guusleenders/Multi-RAT-for-IoT--The-Potential-in-Combining-LoRaWAN-and-NB-IoT/Experiments/LoRaWAN/lora-latency.tex

% This file was created by tikzplotlib v0.9.1.
\begin{tikzpicture}

\begin{axis}
[
axis line style={black},
axis lines* = {left},
legend cell align={left},
legend style={fill opacity=1, draw=none, text opacity=1},
legend style={nodes={scale=0.7, transform shape}, at={(0.03,0.8)},anchor=west},
tick align=outside,
tick pos=left,
width = \linewidth,
height = 0.7\linewidth,
x grid style={white!69.01960784313725!black},
grid,
grid style={help lines,color=gray!50, dashed},
xlabel={data block\_size},
xmajorgrids,
xmin=-71.20000, xmax=1671.20000,
xtick style={color=black},
xlabel={Data Block Size [\si{\byte}]},
ylabel={Latency (\si{\hour})},
ymajorgrids,
ymin=-0.26150, ymax=24.49369,
ytick style={color=black},
label style={font=\footnotesize},
tick label style={font=\footnotesize},
minor tick num=1,
yminorgrids,
ymajorgrids,
xminorgrids,
y filter/.code={\pgfmathparse{#1*3.1}\pgfmathresult}
]
\addplot [thick, colorSF7]
table {%
% 8.00000 0.00010
% 16.00000 0.00016
% 24.00000 0.00020
% 32.00000 0.00024
% 40.00000 0.00028
% 48.00000 0.00034
% 56.00000 0.00038
% 64.00000 0.00042
% 72.00000 0.00047
% 80.00000 0.00051
% 88.00000 0.00055
% 96.00000 0.00059
% 104.00000 0.00065
% 112.00000 0.00069
% 120.00000 0.00073
% 128.00000 0.00079
% 136.00000 0.00083
% 144.00000 0.00086
% 152.00000 0.00090
% 160.00000 0.00096
% 168.00000 0.00100
% 176.00000 0.00104
% 184.00000 0.00110
% 192.00000 0.00114
% 200.00000 0.00118
% 208.00000 0.00122
% 216.00000 0.00128
% 224.00000 0.00131
% 232.00000 0.00144
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
% 232.00000 0.10068
% 240.00000 0.12773
% 248.00000 0.13398
% 256.00000 0.13961
% 264.00000 0.14336
% 272.00000 0.14961
% 280.00000 0.15274
% 288.00000 0.15899
% 296.00000 0.19667
% 304.00000 0.20042
% 312.00000 0.20793
% 320.00000 0.21168
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
};
\addlegendentry{SF12}
\end{axis}

\end{tikzpicture}
