guusleenders/Multi-RAT-for-IoT--The-Potential-in-Combining-LoRaWAN-and-NB-IoT/Experiments/LoRaWAN/lora_energy_per_payload_byte.tex

% This file was created by tikzplotlib v0.9.1.
\begin{tikzpicture}

\begin{axis}[
axis line style={black},
axis lines* = {left},
legend cell align={left},
legend style={ at={(0.5,-0.3)},anchor=north, fill opacity=0.8, draw opacity=1, text opacity=1, draw=white!80.00000!black, /tikz/column 2/.style={column sep=5pt}, /tikz/column 3/.style={column sep=5pt},/tikz/column 4/.style={column sep=5pt}},
legend style={nodes={scale=0.7, transform shape}},
legend columns=4, 
tick align=outside,
tick pos=left,
width = \linewidth,
height=0.6\linewidth,
x grid style={white!69.01960784313725!black},
grid,
grid style={help lines,color=gray!50, dashed},
xlabel={payload\_size},
xmajorgrids,
xmin=-5, xmax=800,
xtick style={color=black},
%ylabel={energy\_per\_payload\_byte},
xlabel={Payload Size [\si{\byte}]},
ylabel={\(E_B\) [\si{\milli\joule/\byte}]},
ymajorgrids,
ymin=-0.72335, ymax=50,
ytick style={color=black},
label style={font=\footnotesize},
tick label style={font=\footnotesize},
minor tick num=1,
yminorgrids,
ymajorgrids,
xminorgrids
]

\addplot [thick, colorSF7]
table {%
8.00000 0.88603
16.00000 0.69617
24.00000 0.57662
32.00000 0.51685
40.00000 0.48099
48.00000 0.48521
56.00000 0.46411
64.00000 0.44829
72.00000 0.45474
80.00000 0.44302
88.00000 0.43343
96.00000 0.42544
104.00000 0.43166
112.00000 0.42493
120.00000 0.41911
128.00000 0.42456
136.00000 0.41944
144.00000 0.41489
152.00000 0.41082
160.00000 0.41559
168.00000 0.41187
176.00000 0.40850
184.00000 0.41275
192.00000 0.40961
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
    \ref{pgfplots:sf8} & SF8 & \ref{pgfplots:sf10} & SF10 & \ref{pgfplots:sf12} & SF12 & \ref{pgfplots:celevel2} & CE Level 2\\
    \end{tabular}};
\node[fill=white,inner sep=0pt,below right] at (0, -2.7) {};
    
\end{tikzpicture}
