guusleenders/Multi-RAT-for-IoT--The-Potential-in-Combining-LoRaWAN-and-NB-IoT/Experiments/LoRaWAN/lora_energyplot.tex

% This file was created by matplotlib2tikz v0.7.4.
\begin{tikzpicture}

\colorlet{color1}{colorCE0}
\colorlet{color4}{colorCE1}
\colorlet{color5}{colorCE2}

\begin{axis}[
height=2in,
width = \linewidth,
axis lines* = {left},
legend style={at={(0.4,-0.20)}, draw={none},
anchor=north,legend columns=3, column sep=2ex, nodes={scale=0.8, transform shape}},
tick align=outside,
tick pos=left,
x grid style={white!69.01960784313725!black},
grid,
grid style={help lines,color=gray!50, dashed},
xlabel={Time (\si{\sec})},
xmin=0, xmax=2.5,
xtick style={color=black},
y grid style={white!69.01960784313725!black},
ylabel={Power (\si{\milli\watt})},
ymin=-19.58160, ymax=500,%428.72560
ytick style={color=black},
label style={font=\footnotesize},
tick label style={font=\footnotesize},
minor tick num=1,
yminorgrids,
ymajorgrids,
xminorgrids
]

\node[circle,draw=black, inner sep=2pt,minimum size=5pt] at (0.2, 460)   (1) {1};
\node[circle,draw=black, inner sep=2pt,minimum size=5pt] at (1.1, 460)   (2) {2};
\node[circle,draw=black, inner sep=2pt,minimum size=5pt] at (1.35, 460)  (2) {3};
\node[circle,draw=black, inner sep=2pt,minimum size=5pt] at (2.1, 460)   (2) {4};
\node[circle,draw=black, inner sep=2pt,minimum size=5pt] at (2.35, 460)  (3) {5};

\addplot [thick, color1]
table[row sep=\\] {%
0.00000 -0.00226\\0.00200 0.00718\\0.00400 0.00542\\0.00600 0.00995\\0.00800 0.00762\\0.01000 0.00340\\0.01200 -0.00087\\0.01400 0.00417\\0.01600 0.00538\\0.01800 0.00698\\0.02000 0.01268\\0.02200 0.01336\\0.02400 0.00455\\0.02600 0.00530\\0.02800 0.00374\\0.03000 0.00918\\0.03200 0.00865\\0.03400 0.00079\\0.03600 0.00670\\0.03800 0.01067\\0.04000 0.01283\\0.04200 0.00607\\0.04400 0.00430\\0.04600 0.01184\\0.04800 0.00314\\0.05000 0.00708\\0.05200 0.00350\\0.05400 0.01115\\0.05600 0.00567\\0.05800 0.00467\\0.06000 0.00774\\0.06200 0.00365\\0.06400 0.04491\\0.06600 0.00476\\0.06800 0.00570\\0.07000 0.00722\\0.07200 6.69480\\0.07400 16.49094\\0.07600 16.50408\\0.07800 16.49930\\0.08000 15.09134\\0.08200 15.11796\\0.08400 15.11796\\0.08600 15.10465\\0.08800 14.68769\\0.09000 8.32468\\0.09200 8.39897\\0.09400 8.33798\\0.09600 8.36460\\0.09800 8.38678\\0.10000 8.37347\\0.10200 8.36903\\0.10400 8.19604\\0.10600 8.40857\\0.10800 15.68738\\0.11000 13.28587\\0.11200 145.26899\\0.11400 145.26899\\0.11600 145.26899\\0.11800 145.26899\\0.12000 145.26899\\0.12200 145.26899\\0.12400 145.26899\\0.12600 145.26899\\0.12800 145.26899\\0.13000 145.26899\\0.13200 145.28187\\0.13400 145.28187\\0.13600 145.28187\\0.13800 145.28187\\0.14000 145.28187\\0.14200 145.28187\\0.14400 145.28187\\0.14600 145.28187\\0.14800 145.28187\\0.15000 145.28187\\0.15200 145.28187\\0.15400 145.28187\\0.15600 145.29475\\0.15800 145.29475\\0.16000 145.29475\\0.16200 145.29475\\0.16400 145.29475\\0.16600 145.29475\\0.16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
\end{axis}

\end{tikzpicture}
