guusleenders/Multi-RAT-for-IoT--The-Potential-in-Combining-LoRaWAN-and-NB-IoT/Experiments/NB-IoT/celevels.tex

%% Creator: Inkscape inkscape 0.92.1, www.inkscape.org
%% PDF/EPS/PS + LaTeX output extension by Johan Engelen, 2010
%% Accompanies image file 'drawing-3.pdf' (pdf, eps, ps)
%%
%% To include the image in your LaTeX document, write
%%   \input{<filename>.pdf_tex}
%%  instead of
%%   \includegraphics{<filename>.pdf}
%% To scale the image, write
%%   \def\svgwidth{<desired width>}
%%   \input{<filename>.pdf_tex}
%%  instead of
%%   \includegraphics[width=<desired width>]{<filename>.pdf}
%%
%% Images with a different path to the parent latex file can
%% be accessed with the `import' package (which may need to be
%% installed) using
%%   \usepackage{import}
%% in the preamble, and then including the image with
%%   \import{<path to file>}{<filename>.pdf_tex}
%% Alternatively, one can specify
%%   \graphicspath{{<path to file>/}}
%% 
%% For more information, please see info/svg-inkscape on CTAN:
%%   http://tug.ctan.org/tex-archive/info/svg-inkscape
%%
\begingroup%
  \makeatletter%
  \providecommand\color[2][]{%
    \errmessage{(Inkscape) Color is used for the text in Inkscape, but the package 'color.sty' is not loaded}%
    \renewcommand\color[2][]{}%
  }%
  \providecommand\transparent[1]{%
    \errmessage{(Inkscape) Transparency is used (non-zero) for the text in Inkscape, but the package 'transparent.sty' is not loaded}%
    \renewcommand\transparent[1]{}%
  }%
  \providecommand\rotatebox[2]{#2}%
  \ifx\svgwidth\undefined%
    \setlength{\unitlength}{375.27203417bp}%
    \ifx\svgscale\undefined%
      \relax%
    \else%
      \setlength{\unitlength}{\unitlength * \real{\svgscale}}%
    \fi%
  \else%
    \setlength{\unitlength}{\svgwidth}%
  \fi%
  \global\let\svgwidth\undefined%
  \global\let\svgscale\undefined%
  \makeatother%
  \begin{picture}(1,0.55229833)%
    \put(0,0){}%
    \put(0.09325084,0.37615397){\color[rgb]{0,0,0}\makebox(0,0)[lt]{\begin{minipage}{0.13172936\unitlength}\raggedright \end{minipage}}}%
    \put(0.02112606,0.43798021){\color[rgb]{0,0,0}\makebox(0,0)[lt]{\begin{minipage}{0.24191953\unitlength}\raggedright \setstretch{0.9} \centering { \footnotesize Coverage Extension 2}\end{minipage}}}%
    \put(0.30144073,0.43797802){\color[rgb]{0,0,0}\makebox(0,0)[lt]{\begin{minipage}{0.24191494\unitlength}\raggedright \setstretch{0.9} \centering {\footnotesize Coverage Extension 1}\end{minipage}}}%
    \put(0.57210484,0.43797802){\color[rgb]{0,0,0}\makebox(0,0)[lt]{\begin{minipage}{0.24191953\unitlength}\raggedright \setstretch{0.9} \centering {\footnotesize Coverage Extension 0}\end{minipage}}}%
    \put(0.84519115,0.26841871){\color[rgb]{0,0,0}\makebox(0,0)[lt]{\begin{minipage}{0.24191953\unitlength}\raggedright {\footnotesize RSRP [dBm]}\end{minipage}}}%
    \put(0.54685295,0.22563115){\color[rgb]{0,0,0}\rotatebox{-45}{\makebox(0,0)[lt]{\begin{minipage}{0.34327456\unitlength}\raggedright {\footnotesize RSRP Threshold 2}\end{minipage}}}}%
    \put(0.28075076,0.22563115){\color[rgb]{0,0,0}\rotatebox{-45}{\makebox(0,0)[lt]{\begin{minipage}{0.33042673\unitlength}\raggedright {\footnotesize RSRP Threshold 1}\end{minipage}}}}%
  \end{picture}%
\endgroup%
