guusleenders/Multi-RAT-for-IoT--The-Potential-in-Combining-LoRaWAN-and-NB-IoT/Experiments/NB-IoT/energyplot.tex

% This file was created by matplotlib2tikz v0.7.4.
\begin{tikzpicture}
\colorlet{color1}{colorCE0}
\colorlet{color4}{colorCE1}
\colorlet{color5}{colorCE2}

\begin{axis}[
height=2in,
width = \linewidth,
axis lines* = {left},
legend style={at={(0.4,-0.20)}, draw={none},
anchor=north,legend columns=3, column sep=2ex, nodes={scale=0.8, transform shape}},
tick align=outside,
tick pos=left,
x grid style={white!69.01960784313725!black},
grid,
grid style={help lines,color=gray!50, dashed},
xlabel={Time (\si{\sec})},
xmin=0, xmax=120,
xtick style={color=black},
y grid style={white!69.01960784313725!black},
ylabel={Power (\si{\milli\watt})},
ymin=-19.58160, ymax=500,%428.72560
ytick style={color=black},
label style={font=\footnotesize},
tick label style={font=\footnotesize},
minor tick num=1,
yminorgrids,
ymajorgrids,
xminorgrids
]

\node[circle,draw=black, inner sep=2pt,minimum size=5pt] at (9, 460)   (1) {1};
\node[circle,draw=black, inner sep=2pt,minimum size=5pt] at (21, 460)   (2) {2};
\node[circle,draw=black, inner sep=2pt,minimum size=5pt] at (33, 460)   (3) {3};
\node[circle,draw=black, inner sep=2pt,minimum size=5pt] at (70, 460)   (4) {4};
\node[circle,draw=black, inner sep=2pt,minimum size=5pt] at (115, 460)   (5) {5};

\addplot [semithick, color1]
table[row sep=\\] {%
0.10526 8.75600\\0.21053 10.34800\\0.31579 10.34800\\0.42105 8.75600\\0.52632 5.57200\\0.63158 7.16400\\0.73684 7.16400\\0.84211 7.16400\\0.94737 7.16400\\1.05263 7.16400\\1.15790 11.94000\\1.26316 11.94000\\1.36842 11.94000\\1.47368 11.94000\\1.57895 11.94000\\1.68421 13.53200\\1.78947 8.75600\\1.89474 10.34800\\2.00000 7.16400\\2.10526 7.16400\\2.21053 8.75600\\2.31579 10.34800\\2.42105 3.98000\\2.52632 3.98000\\2.63158 132.93200\\2.73684 129.74800\\2.84211 150.44400\\2.94737 150.44400\\3.05263 169.54800\\3.15790 169.54800\\3.26316 97.90800\\3.36842 97.90800\\3.47369 204.57200\\3.57895 202.98000\\3.68421 134.52400\\3.78948 134.52400\\3.89474 155.22000\\4.00000 155.22000\\4.10526 172.73200\\4.21053 172.73200\\4.31579 187.06000\\4.42105 188.65200\\4.52632 210.94000\\4.63158 210.94000\\4.73684 209.34800\\4.84211 209.34800\\4.94737 206.16400\\5.05263 206.16400\\5.15790 206.16400\\5.26316 206.16400\\5.36842 209.34800\\5.47369 207.75600\\5.57895 212.53200\\5.68421 210.94000\\5.78948 206.16400\\5.89474 206.16400\\6.00000 209.34800\\6.10527 209.34800\\6.21053 209.34800\\6.31579 209.34800\\6.42106 207.75600\\6.52632 209.34800\\6.63158 210.94000\\6.73684 210.94000\\6.84211 212.53200\\6.94737 210.94000\\7.05263 218.90000\\7.15790 218.90000\\7.26316 212.53200\\7.36842 210.94000\\7.47369 212.53200\\7.57895 212.53200\\7.68421 260.29200\\7.78948 258.70000\\7.89474 296.90800\\8.00000 296.90800\\8.10527 273.02800\\8.21053 273.02800\\8.31579 296.90800\\8.42106 295.31600\\8.52632 301.68400\\8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
\end{axis}

\end{tikzpicture}
