guusleenders/Multi-RAT-for-IoT--The-Potential-in-Combining-LoRaWAN-and-NB-IoT/Experiments/NB-IoT/latency_boxplot.tex

% This file was created by tikzplotlib v0.8.5.
\begin{tikzpicture}

\begin{axis}[
axis lines* = {left},
tick align=outside,
tick pos=left,
width = \linewidth,
height = 0.7\linewidth,
x grid style={white!69.01960784313725!black},
grid,
grid style={help lines,color=gray!50, dashed},
xmajorgrids,
xmin=0.50000, xmax=3.50000,
xtick style={color=black},
xtick={1.00000,2.00000,3.00000},
xticklabels={CE Level 0,CE Level 1, CE Level 2},
minor tick num=1,
yminorgrids,
ymajorgrids,
ylabel={Latency [\si{\second}]},
ymin=0, ymax=20.5,
ytick style={color=black},
boxplot/draw direction=y,
label style={font=\footnotesize},
tick label style={font=\footnotesize}
]

\addplot[mark = x, mark options = {mark color=grey},
boxplot prepared={
    lower whisker=0.301, 
    lower quartile=0.55450,
    median=0.85900,
    upper quartile=1.23100, 
    upper whisker=1.231,
    box extend=0.4}, 
    color=colorDarkCE0,
]
coordinates{
(1, 2.26300)
(1, 3.00300)
(1, 5.34500)
(1, 2.42600)
(1, 3.42200)
}
node[right,font=\footnotesize] at
(boxplot box cs: \boxplotvalue{median},1.1)
{\pgfmathprintnumber{\boxplotvalue{median}}};;

\addplot[mark = x, mark options = {mark color=grey},
boxplot prepared={
    lower whisker=0.448, 
    lower quartile=0.7505,
    median=1.117,
    upper quartile=1.6, 
    upper whisker=1.95,
    box extend=0.4}, 
    color=colorDarkCE1
]
coordinates{
(2, 9.63600)
(2, 3.44700)
}
node[right,inner sep=1pt,font=\footnotesize] at
(boxplot box cs: \boxplotvalue{median},1.1)
{\pgfmathprintnumber{\boxplotvalue{median}}};;

\addplot[mark = x, mark options = {mark color=grey},
boxplot prepared={
    lower whisker=1.395, 
    lower quartile=1.6715,
    median=1.915,
    upper quartile=2.1895, 
    upper whisker=9.16,
    box extend=0.4}, 
    color=colorDarkCE2
]
coordinates{
(3.00000 ,0.72500)
(3.00000 ,0.70400)
(3.00000 ,0.67100)
(3.00000 ,0.70900)
(3.00000 ,0.69400)
(3.00000 ,0.73600)
(3.00000 ,0.65700)
(3.00000 ,0.72200)
(3.00000 ,0.54200)
(3.00000 ,0.87100)
(3.00000 ,5.95000)
(3.00000 ,3.01900)
(3.00000 ,4.69900)
(3.00000 ,13.11500)
(3.00000 ,12.70200)
(3.00000, 8.15800)
(3.00000, 13.10800)
(3.00000, 5.68100)
(3.00000, 15.76600)
(3.00000, 6.81500)
(3.00000, 16.27500)
(3.00000, 10.82400)
(3.00000, 3.96200)
(3.00000, 3.70600)
(3.00000, 15.28800)
(3.00000, 3.43400)
(3.00000, 9.91600)
(3.00000, 3.38100)
(3.00000, 9.11200)
(3.00000, 9.67800)
(3.00000, 16.22900)
(3.00000, 5.25500)
(3.00000, 12.48700)
(3.00000, 21.67800)
(3.00000, 7.83200)
(3.00000, 14.68500)
(3.00000, 10.04800)
(3.00000, 13.46300)
(3.00000, 14.74700)
(3.00000, 7.48200)
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
}
node[right,inner sep=1pt,font=\footnotesize] at
(boxplot box cs: \boxplotvalue{median},1.1)
{\pgfmathprintnumber{\boxplotvalue{median}}};;
\end{axis}

\end{tikzpicture}
