guusleenders/Multi-RAT-for-IoT--The-Potential-in-Combining-LoRaWAN-and-NB-IoT/Experiments/NB-IoT/perbyte.tex

% This file was created by tikzplotlib v0.8.5.
\begin{tikzpicture}

\begin{axis}[
axis lines* = {left},
legend cell align={left},
legend style={draw=white!80.0!black},
tick align=outside,
tick pos=left,
width = \linewidth,
height = 0.7\linewidth,
x grid style={white!69.01960784313725!black},
grid,
grid style={help lines,color=gray!10, dashed},
xlabel={payload},
xmin=-6.40000, xmax=300.00000,
xtick style={color=black},
y grid style={white!69.01960784313725!black},
legend style={draw=none, nodes={scale=0.7, transform shape}},
minor tick num=1,
yminorgrids,
ymajorgrids,
xminorgrids,
xlabel={Payload size [\si{\byte}]},
ylabel={\(E_B\) [\si{\milli\joule}]},
xmin=-6.40000, xmax=310,
ytick style={color=black},
label style={font=\footnotesize},
tick label style={font=\footnotesize}
]
\addplot [thick, colorCE0, y filter/.code={\pgfmathparse{#1*1000}\pgfmathresult}]
table [row sep=\\] {%
10.00000 0.16216\\
20.00000 0.08701\\
40.00000 0.04116\\
60.00000 0.02753\\
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
\addlegendentry{CE Level 2}
\end{axis}

\end{tikzpicture}
