guusleenders/Multi-RAT-for-IoT--The-Potential-in-Combining-LoRaWAN-and-NB-IoT/Experiments/NB-IoT/Measurement Files/Latency CE Level/Result/latency.tex

% This file was created by tikzplotlib v0.8.5.
\begin{tikzpicture}

\definecolor{color0}{rgb}{0.12157,0.46667,0.70588}
\definecolor{color1}{rgb}{0.17255,0.62745,0.17255}

\begin{axis}[
axis lines* = {left},
tick align=outside,
tick pos=left,
width = \linewidth,
x grid style={white!69.01960784313725!black},
xmajorgrids,
xmin=0.50000, xmax=3.50000,
xtick style={color=black},
xtick={1.00000,2.00000,3.00000},
xticklabels={A,B,C},
y grid style={white!69.01960784313725!black},
ymajorgrids,
ymin=-1.00590, ymax=24.68790,
ytick style={color=black}
]
\addplot [color0, opacity=1]
table [row sep=\\] {%
0.85000 0.55450\\1.15000 0.55450\\1.15000 1.23100\\0.85000 1.23100\\0.85000 0.55450\\};
\addplot [color0, opacity=1]
table [row sep=\\] {%
1.00000 0.55450\\1.00000 0.22700\\};
\addplot [color0, opacity=1]
table [row sep=\\] {%
1.00000 1.23100\\1.00000 2.22400\\};
\addplot [black]
table [row sep=\\] {%
0.92500 0.22700\\1.07500 0.22700\\};
\addplot [black]
table [row sep=\\] {%
0.92500 2.22400\\1.07500 2.22400\\};
\addplot [black, mark=*, mark size=3, mark options={solid,fill opacity=0}, only marks]
table [row sep=\\] {%
1.00000 2.26300\\1.00000 3.00300\\1.00000 5.34500\\1.00000 2.42600\\1.00000 3.42200\\};
\addplot [color0, opacity=1]
table [row sep=\\] {%
1.85000 0.75050\\2.15000 0.75050\\2.15000 1.60000\\1.85000 1.60000\\1.85000 0.75050\\};
\addplot [color0, opacity=1]
table [row sep=\\] {%
2.00000 0.75050\\2.00000 0.16200\\};
\addplot [color0, opacity=1]
table [row sep=\\] {%
2.00000 1.60000\\2.00000 2.71300\\};
\addplot [black]
table [row sep=\\] {%
1.92500 0.16200\\2.07500 0.16200\\};
\addplot [black]
table [row sep=\\] {%
1.92500 2.71300\\2.07500 2.71300\\};
\addplot [black, mark=*, mark size=3, mark options={solid,fill opacity=0}, only marks]
table [row sep=\\] {%
2.00000 9.63600\\2.00000 3.44700\\};
\addplot [color0, opacity=1]
table [row sep=\\] {%
2.85000 1.67150\\3.15000 1.67150\\3.15000 2.18950\\2.85000 2.18950\\2.85000 1.67150\\};
\addplot [color0, opacity=1]
table [row sep=\\] {%
3.00000 1.67150\\3.00000 0.89800\\};
\addplot [color0, opacity=1]
table [row sep=\\] {%
3.00000 2.18950\\3.00000 2.95600\\};
\addplot [black]
table [row sep=\\] {%
2.92500 0.89800\\3.07500 0.89800\\};
\addplot [black]
table [row sep=\\] {%
2.92500 2.95600\\3.07500 2.95600\\};
\addplot [black, mark=*, mark size=3, mark options={solid,fill opacity=0}, only marks]
table [row sep=\\] {%
3.00000 0.72500\\3.00000 0.70400\\3.00000 0.67100\\3.00000 0.70900\\3.00000 0.69400\\3.00000 0.73600\\3.00000 0.65700\\3.00000 0.72200\\3.00000 0.54200\\3.00000 0.87100\\3.00000 5.95000\\3.00000 3.01900\\3.00000 4.69900\\3.00000 13.11500\\3.00000 12.70200\\3.00000 8.15800\\3.00000 13.10800\\3.00000 5.68100\\3.00000 15.76600\\3.00000 6.81500\\3.00000 16.27500\\3.00000 10.82400\\3.00000 3.96200\\3.00000 3.70600\\3.00000 15.28800\\3.00000 3.43400\\3.00000 9.91600\\3.00000 3.38100\\3.00000 9.11200\\3.00000 9.67800\\3.00000 16.22900\\3.00000 5.25500\\3.00000 12.48700\\3.00000 21.67800\\3.00000 7.83200\\3.00000 14.68500\\3.00000 10.04800\\3.00000 13.46300\\3.00000 14.74700\\3.00000 7.48200\\3.00000 5.72400\\3.00000 6.26300\\3.00000 4.07000\\3.00000 6.90300\\3.00000 6.48400\\3.00000 14.21600\\3.00000 4.46700\\3.00000 6.46900\\3.00000 3.07000\\3.00000 4.55700\\3.00000 5.75500\\3.00000 15.02500\\3.00000 23.52000\\3.00000 5.08600\\3.00000 14.99400\\3.00000 17.15000\\3.00000 17.39200\\3.00000 9.81500\\3.00000 11.50900\\3.00000 9.56200\\};
\addplot [color1, opacity=1]
table [row sep=\\] {%
0.85000 0.85900\\1.15000 0.85900\\};
\addplot [color1, opacity=1]
table [row sep=\\] {%
1.85000 1.11700\\2.15000 1.11700\\};
\addplot [color1, opacity=1]
table [row sep=\\] {%
2.85000 1.91500\\3.15000 1.91500\\};
\end{axis}

\end{tikzpicture}
