guusleenders/Multi-RAT-for-IoT--The-Potential-in-Combining-LoRaWAN-and-NB-IoT/Experiments/NB-IoT/Measurement Files/Power Payload/Result/payload.tex

% This file was created by tikzplotlib v0.8.5.
\begin{tikzpicture}

\begin{axis}[
axis lines* = {left},
legend cell align={left},
legend style={at={(0.03000,0.97000)}, anchor=north west, draw=white!80.0!black},
tick align=outside,
tick pos=left,
width = \linewidth,
x grid style={white!69.01960784313725!black},
xlabel={payload},
xmin=-70.05038, xmax=1532.86426,
xtick style={color=black},
y grid style={white!69.01960784313725!black},
ylabel={packet},
ymin=1.31730, ymax=6.93170,
ytick style={color=black}
]
\addplot [only marks, marker=*, draw=red, fill=red, colormap/viridis]
table{%
x                      y
10.00000 1.62156
20.00000 1.74018
40.00000 1.64651
60.00000 1.65153
80.00000 1.62865
100.00000 1.76427
120.00000 1.62921
140.00000 1.57855
160.00000 1.68423
180.00000 1.63911
200.00000 1.64911
220.00000 1.67428
240.00000 1.82636
260.00000 1.63739
280.00000 1.64764
300.00000 1.68065
320.00000 1.65173
340.00000 1.69803
360.00000 1.86661
380.00000 1.70058
400.00000 1.71115
420.00000 1.66791
440.00000 1.77939
460.00000 1.82643
480.00000 1.91591
500.00000 1.96921
520.00000 2.07261
540.00000 1.78617
560.00000 1.77075
580.00000 1.78812
600.00000 1.81778
620.00000 1.88447
640.00000 1.83735
660.00000 1.85647
680.00000 1.84557
700.00000 1.80397
720.00000 2.09737
740.00000 1.83930
760.00000 2.18211
780.00000 1.97019
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
};
\addlegendentry{A}
\addplot [only marks, marker=*, draw=green!50.19607843137255!black, fill=green!50.19607843137255!black, colormap/viridis]
table{%
x                      y
10.00000 2.91371
20.00000 2.27360
40.00000 2.38557
60.00000 2.60864
80.00000 2.46182
100.00000 2.45827
120.00000 2.39298
140.00000 2.20304
160.00000 2.88585
200.00000 2.77154
240.00000 2.47972
260.00000 2.89049
280.00000 2.88426
340.00000 2.72447
360.00000 3.01274
380.00000 2.82839
400.00000 3.02222
420.00000 3.21164
430.00000 4.20062
470.00000 2.92244
490.00000 3.55058
510.00000 3.32072
530.00000 3.50465
550.00000 4.12259
570.00000 3.60557
590.00000 4.27517
610.00000 3.75049
630.00000 3.55809
650.00000 3.92530
670.00000 4.11374
690.00000 4.32429
710.00000 4.14349
730.00000 3.91812
750.00000 3.65741
770.00000 3.74483
790.00000 3.99369
810.00000 4.26293
830.00000 5.07966
850.00000 3.51147
870.00000 5.09128
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
};
\addlegendentry{C}
\end{axis}

\end{tikzpicture}
