guusleenders/Multi-RAT-for-IoT--The-Potential-in-Combining-LoRaWAN-and-NB-IoT/Experiments/NB-IoT/Measurement Files/Power Reception/Meas 1/Desk - 0dB Attenuation.tex

% This file was created by matplotlib2tikz v0.7.4.
\begin{tikzpicture}

\definecolor{color0}{rgb}{0.28235,0.47059,0.81176}

\begin{axis}[
axis lines* = {left},
tick align=outside,
tick pos=left,
unbounded coords=jump,
width = \linewidth,
x grid style={white!69.01960784313725!black},
xlabel={Time (s)},
xmin=0.05000, xmax=60.00000,
xtick style={color=black},
y grid style={white!69.01960784313725!black},
ylabel={Current (mA)},
ymin=-10.56500, ymax=314.26500,
ytick style={color=black}
]
\addplot [semithick, color0]
table {%
0.05000 nan\\0.10000 nan\\0.15000 nan\\0.20000 8.45000\\0.25000 10.60000\\0.30000 12.10000\\0.35000 10.70000\\0.40000 10.70000\\0.45000 8.55000\\0.50000 7.05000\\0.55000 7.75000\\0.60000 7.75000\\0.65000 11.75000\\0.70000 10.00000\\0.75000 12.75000\\0.80000 9.50000\\0.85000 8.00000\\0.90000 7.75000\\0.95000 5.00000\\1.00000 8.25000\\1.05000 6.50000\\1.10000 10.00000\\1.15000 11.75000\\1.20000 7.70000\\1.25000 10.15000\\1.30000 6.10000\\1.35000 4.35000\\1.40000 8.40000\\1.45000 6.65000\\1.50000 10.70000\\1.55000 13.95000\\1.60000 10.70000\\1.65000 12.75000\\1.70000 10.20000\\1.75000 9.50000\\1.80000 9.50000\\1.85000 8.50000\\1.90000 7.55000\\1.95000 6.75000\\2.00000 6.50000\\2.05000 4.75000\\2.10000 8.25000\\2.15000 6.50000\\2.20000 10.00000\\2.25000 10.00000\\2.30000 10.00000\\2.35000 13.25000\\2.40000 10.00000\\2.45000 9.25000\\2.50000 7.75000\\2.55000 7.05000\\2.60000 7.05000\\2.65000 7.80000\\2.70000 9.30000\\2.75000 6.75000\\2.80000 10.00000\\2.85000 12.05000\\2.90000 8.80000\\2.95000 8.50000\\3.00000 7.00000\\3.05000 7.70000\\3.10000 7.70000\\3.15000 10.75000\\3.20000 9.00000\\3.25000 8.00000\\3.30000 7.75000\\3.35000 6.75000\\3.40000 5.95000\\3.45000 4.20000\\3.50000 7.70000\\3.55000 6.65000\\3.60000 10.70000\\3.65000 10.70000\\3.70000 10.70000\\3.75000 9.25000\\3.80000 7.75000\\3.85000 6.95000\\3.90000 5.45000\\3.95000 7.25000\\4.00000 5.25000\\4.05000 8.80000\\4.10000 7.75000\\4.15000 5.95000\\4.20000 7.95000\\4.25000 6.95000\\4.30000 6.00000\\4.35000 8.50000\\4.40000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
\end{axis}

\end{tikzpicture}
