guusleenders/Multi-RAT-for-IoT--The-Potential-in-Combining-LoRaWAN-and-NB-IoT/Experiments/NB-IoT/Measurement Files/Power Reception/Meas 1/Desk - 20dB Attenuation.tex

% This file was created by matplotlib2tikz v0.7.4.
\begin{tikzpicture}

\begin{axis}[
axis lines* = {left},
tick align=outside,
tick pos=left,
width = \linewidth,
x grid style={white!69.01960784313725!black},
xlabel={Time (s)},
xmin=0.00000, xmax=1.00000,
xtick style={color=black},
xtick={0.00000,0.20000,0.40000,0.60000,0.80000,1.00000},
xticklabels={\(\displaystyle 0.0\),\(\displaystyle 0.2\),\(\displaystyle 0.4\),\(\displaystyle 0.6\),\(\displaystyle 0.8\),\(\displaystyle 1.0\)},
y grid style={white!69.01960784313725!black},
ylabel={Current (mA)},
ymin=0.00000, ymax=1.00000,
ytick style={color=black},
ytick={0.00000,0.20000,0.40000,0.60000,0.80000,1.00000},
yticklabels={\(\displaystyle 0.0\),\(\displaystyle 0.2\),\(\displaystyle 0.4\),\(\displaystyle 0.6\),\(\displaystyle 0.8\),\(\displaystyle 1.0\)}
]
\end{axis}

\end{tikzpicture}
