guusleenders/Multi-RAT-for-IoT--The-Potential-in-Combining-LoRaWAN-and-NB-IoT/Experiments/NB-IoT/Measurement Files/Power Reception/Meas 1/Desk - 40dB Attenuation.tex

% This file was created by matplotlib2tikz v0.7.4.
\begin{tikzpicture}

\definecolor{color0}{rgb}{0.12157,0.46667,0.70588}

\begin{axis}[
axis lines* = {left},
legend cell align={left},
legend style={draw=white!80.0!black},
tick align=outside,
tick pos=left,
unbounded coords=jump,
width = \linewidth,
x grid style={white!69.01960784313725!black},
xlabel={Time (s)},
xmin=0.05000, xmax=60.00000,
xtick style={color=black},
xtick={0.00000,20.00000,40.00000,60.00000},
xticklabels={\(\displaystyle 0\),\(\displaystyle 20\),\(\displaystyle 40\),\(\displaystyle 60\)},
y grid style={white!69.01960784313725!black},
ylabel={Power (mW))},
ymin=-6.24250, ymax=243.29250,
ytick style={color=black},
ytick={-100.00000,0.00000,100.00000,200.00000,300.00000},
yticklabels={\(\displaystyle -100\),\(\displaystyle 0\),\(\displaystyle 100\),\(\displaystyle 200\),\(\displaystyle 300\)}
]
\addplot [semithick, color0]
table {%
0.05000 nan\\0.10000 nan\\0.15000 nan\\0.20000 27.30000\\0.25000 26.30000\\0.30000 26.70000\\0.35000 26.70000\\0.40000 27.80000\\0.45000 27.80000\\0.50000 28.30000\\0.55000 29.30000\\0.60000 26.70000\\0.65000 27.70000\\0.70000 26.80000\\0.75000 26.80000\\0.80000 27.30000\\0.85000 23.90000\\0.90000 27.80000\\0.95000 29.20000\\1.00000 27.10000\\1.05000 28.10000\\1.10000 26.60000\\1.15000 23.00000\\1.20000 26.10000\\1.25000 28.50000\\1.30000 25.50000\\1.35000 29.70000\\1.40000 26.70000\\1.45000 26.70000\\1.50000 26.70000\\1.55000 26.10000\\1.60000 26.10000\\1.65000 25.50000\\1.70000 25.50000\\1.75000 22.50000\\1.80000 25.50000\\1.85000 23.10000\\1.90000 26.70000\\1.95000 29.10000\\2.00000 26.10000\\2.05000 26.70000\\2.10000 26.10000\\2.15000 25.30000\\2.20000 27.30000\\2.25000 29.70000\\2.30000 26.70000\\2.35000 25.70000\\2.40000 26.70000\\2.45000 27.30000\\2.50000 27.30000\\2.55000 29.70000\\2.60000 26.70000\\2.65000 22.70000\\2.70000 27.30000\\2.75000 27.30000\\2.80000 27.30000\\2.85000 27.70000\\2.90000 26.70000\\2.95000 27.70000\\3.00000 26.70000\\3.05000 29.70000\\3.10000 25.60000\\3.15000 21.60000\\3.20000 26.10000\\3.25000 25.10000\\3.30000 26.00000\\3.35000 26.00000\\3.40000 26.60000\\3.45000 27.60000\\3.50000 27.80000\\3.55000 31.80000\\3.60000 27.30000\\3.65000 23.30000\\3.70000 27.30000\\3.75000 27.30000\\3.80000 26.70000\\3.85000 30.70000\\3.90000 26.10000\\3.95000 26.10000\\4.00000 26.10000\\4.05000 25.10000\\4.10000 20.70000\\4.15000 15.30000\\4.20000 15.15000\\4.2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
\addlegendentry{avg}
\end{axis}

\end{tikzpicture}
