guusleenders/Multi-RAT-for-IoT--The-Potential-in-Combining-LoRaWAN-and-NB-IoT/Experiments/NB-IoT/Measurement Files/Power Reception/Meas 1/Desk - 60dB Attenuation.tex

% This file was created by matplotlib2tikz v0.7.4.
\begin{tikzpicture}

\definecolor{color0}{rgb}{0.28235,0.47059,0.81176}
\definecolor{color1}{rgb}{0.41569,0.80000,0.39608}
\definecolor{color2}{rgb}{0.83922,0.37255,0.37255}
\definecolor{color3}{rgb}{0.70588,0.48627,0.78039}

\begin{axis}[
axis lines* = {left},
tick align=outside,
tick pos=left,
unbounded coords=jump,
width = \linewidth,
x grid style={white!69.01960784313725!black},
xlabel={Time (s)},
xmin=0.05000, xmax=60.00000,
xtick style={color=black},
y grid style={white!69.01960784313725!black},
ylabel={Current (mA)},
ymin=-10.00000, ymax=400.00000,
ytick style={color=black}
]
\addplot [semithick, color0, opacity=0.25]
table {%
0.05000 nan\\0.10000 nan\\0.15000 nan\\0.20000 7.15000\\0.25000 6.50000\\0.30000 10.00000\\0.35000 8.50000\\0.40000 7.85000\\0.45000 9.20000\\0.50000 6.40000\\0.55000 5.05000\\0.60000 8.55000\\0.65000 7.20000\\0.70000 10.00000\\0.75000 10.65000\\0.80000 7.15000\\0.85000 7.20000\\0.90000 5.00000\\0.95000 7.20000\\1.00000 7.85000\\1.05000 7.35000\\1.10000 8.05000\\1.15000 6.55000\\1.20000 5.55000\\1.25000 6.00000\\1.30000 7.50000\\1.35000 6.15000\\1.40000 10.00000\\1.45000 9.30000\\1.50000 9.30000\\1.55000 10.65000\\1.60000 7.15000\\1.65000 7.85000\\1.70000 7.85000\\1.75000 8.65000\\1.80000 9.30000\\1.85000 8.65000\\1.90000 7.15000\\1.95000 4.35000\\2.00000 5.70000\\2.05000 6.40000\\2.10000 6.40000\\2.15000 6.40000\\2.20000 7.10000\\2.25000 8.40000\\2.30000 6.40000\\2.35000 7.05000\\2.40000 7.85000\\2.45000 6.50000\\2.50000 10.00000\\2.55000 12.35000\\2.60000 8.80000\\2.65000 10.15000\\2.70000 6.65000\\2.75000 6.35000\\2.80000 6.05000\\2.85000 7.05000\\2.90000 7.70000\\2.95000 4.65000\\3.00000 6.30000\\3.05000 5.30000\\3.10000 4.65000\\3.15000 6.35000\\3.20000 8.55000\\3.25000 10.25000\\3.30000 10.90000\\3.35000 10.90000\\3.40000 10.90000\\3.45000 7.10000\\3.50000 18.35000\\3.55000 23.70000\\3.60000 34.60000\\3.65000 46.90000\\3.70000 44.50000\\3.75000 50.10000\\3.80000 43.20000\\3.85000 40.00000\\3.90000 42.90000\\3.95000 43.00000\\4.00000 40.60000\\4.05000 34.80000\\4.10000 34.00000\\4.15000 28.50000\\4.20000 37.80000\\4.25000 49.00000\\4.30000 46.10000\\4.35000 52.20000\\4.4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
\addplot [semithick, color2, opacity=0.75]
table {%
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
