guusleenders/Multi-RAT-for-IoT--The-Potential-in-Combining-LoRaWAN-and-NB-IoT/Experiments/NB-IoT/Measurement Files/Power Reception/Meas 1/Desk - 20dB Attenuation.pdf

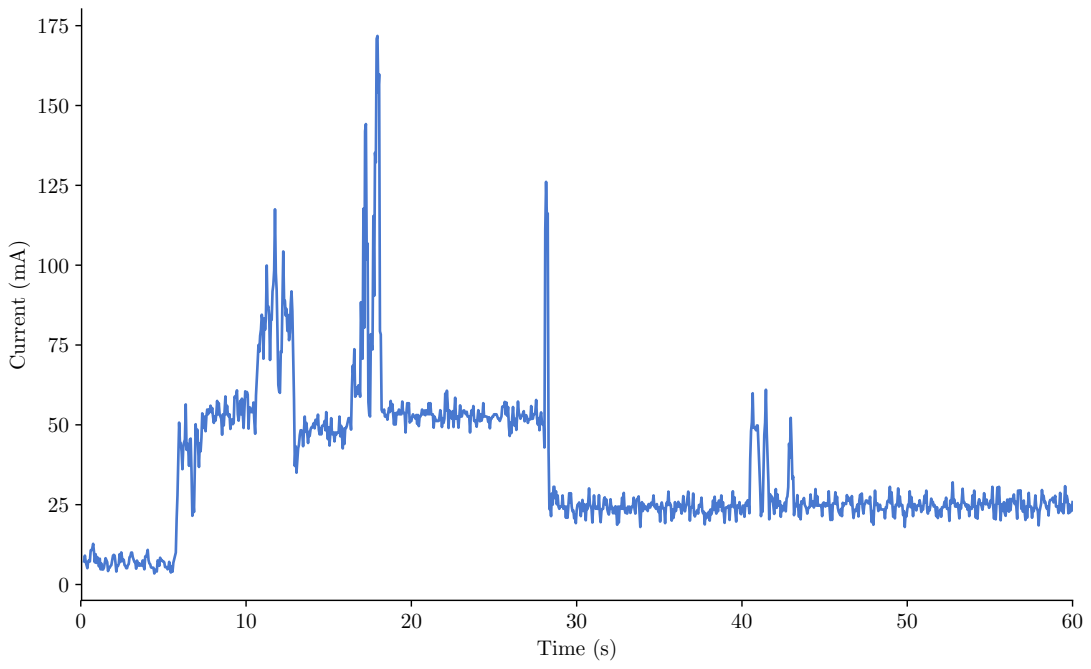
[picture p4: page 1]
Time (s); Current (mA)
