guusleenders/Multi-RAT-for-IoT--The-Potential-in-Combining-LoRaWAN-and-NB-IoT/Experiments/NB-IoT/Measurement Files/Power Reception/Meas 1/Desk - 40dB Attenuation (2).pdf

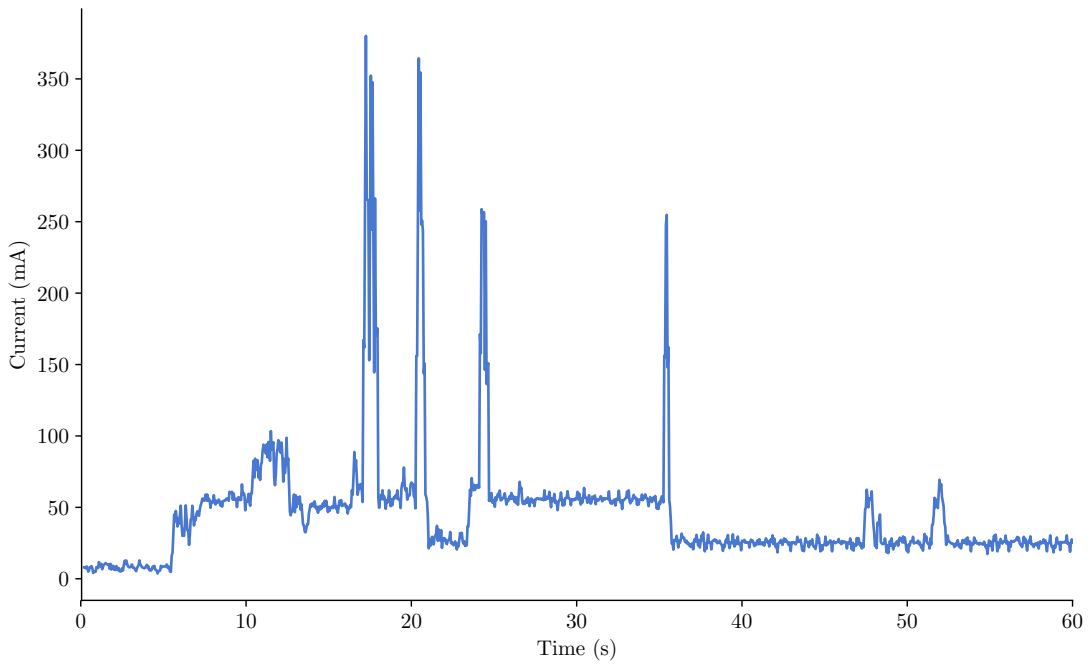
[picture p5: page 1]
Time (s); Current (mA)
