guusleenders/Multi-RAT-for-IoT--The-Potential-in-Combining-LoRaWAN-and-NB-IoT/Experiments/NB-IoT/Measurement Files/Power Reception/Meas 1/Desk - 60dB Attenuation.pdf

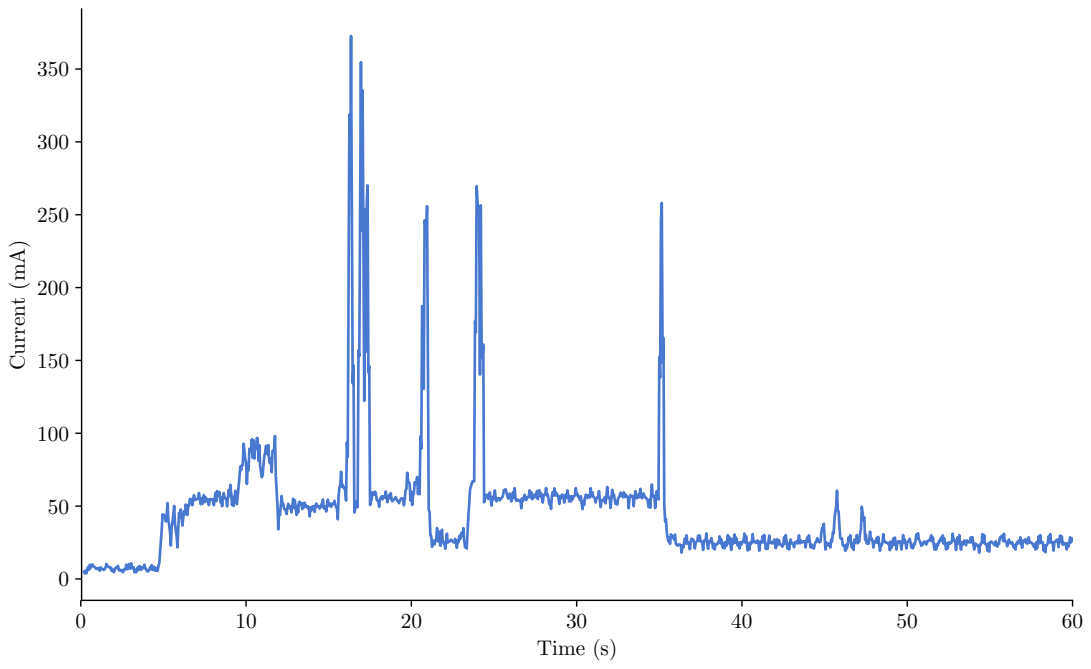
[picture p6: page 1]
Time (s); Current (mA)
