guusleenders/Multi-RAT-for-IoT--The-Potential-in-Combining-LoRaWAN-and-NB-IoT/Experiments/NB-IoT/Measurement Files/Power Reception/Meas 1/Desk - 0dB Attenuation (4).pdf

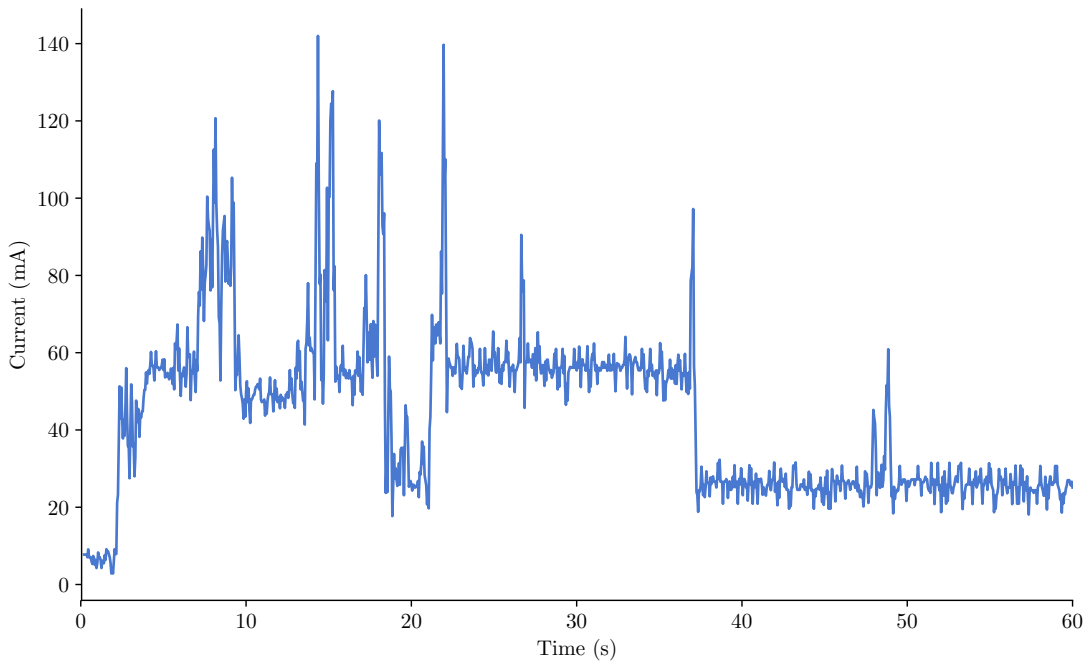
[picture p7: page 1]
Time (s); Current (mA)
