guusleenders/Multi-RAT-for-IoT--The-Potential-in-Combining-LoRaWAN-and-NB-IoT/Firmware/LoRaWAN/LoRaWAN_EFM32/DOC/Eagle/v3.2.pdf

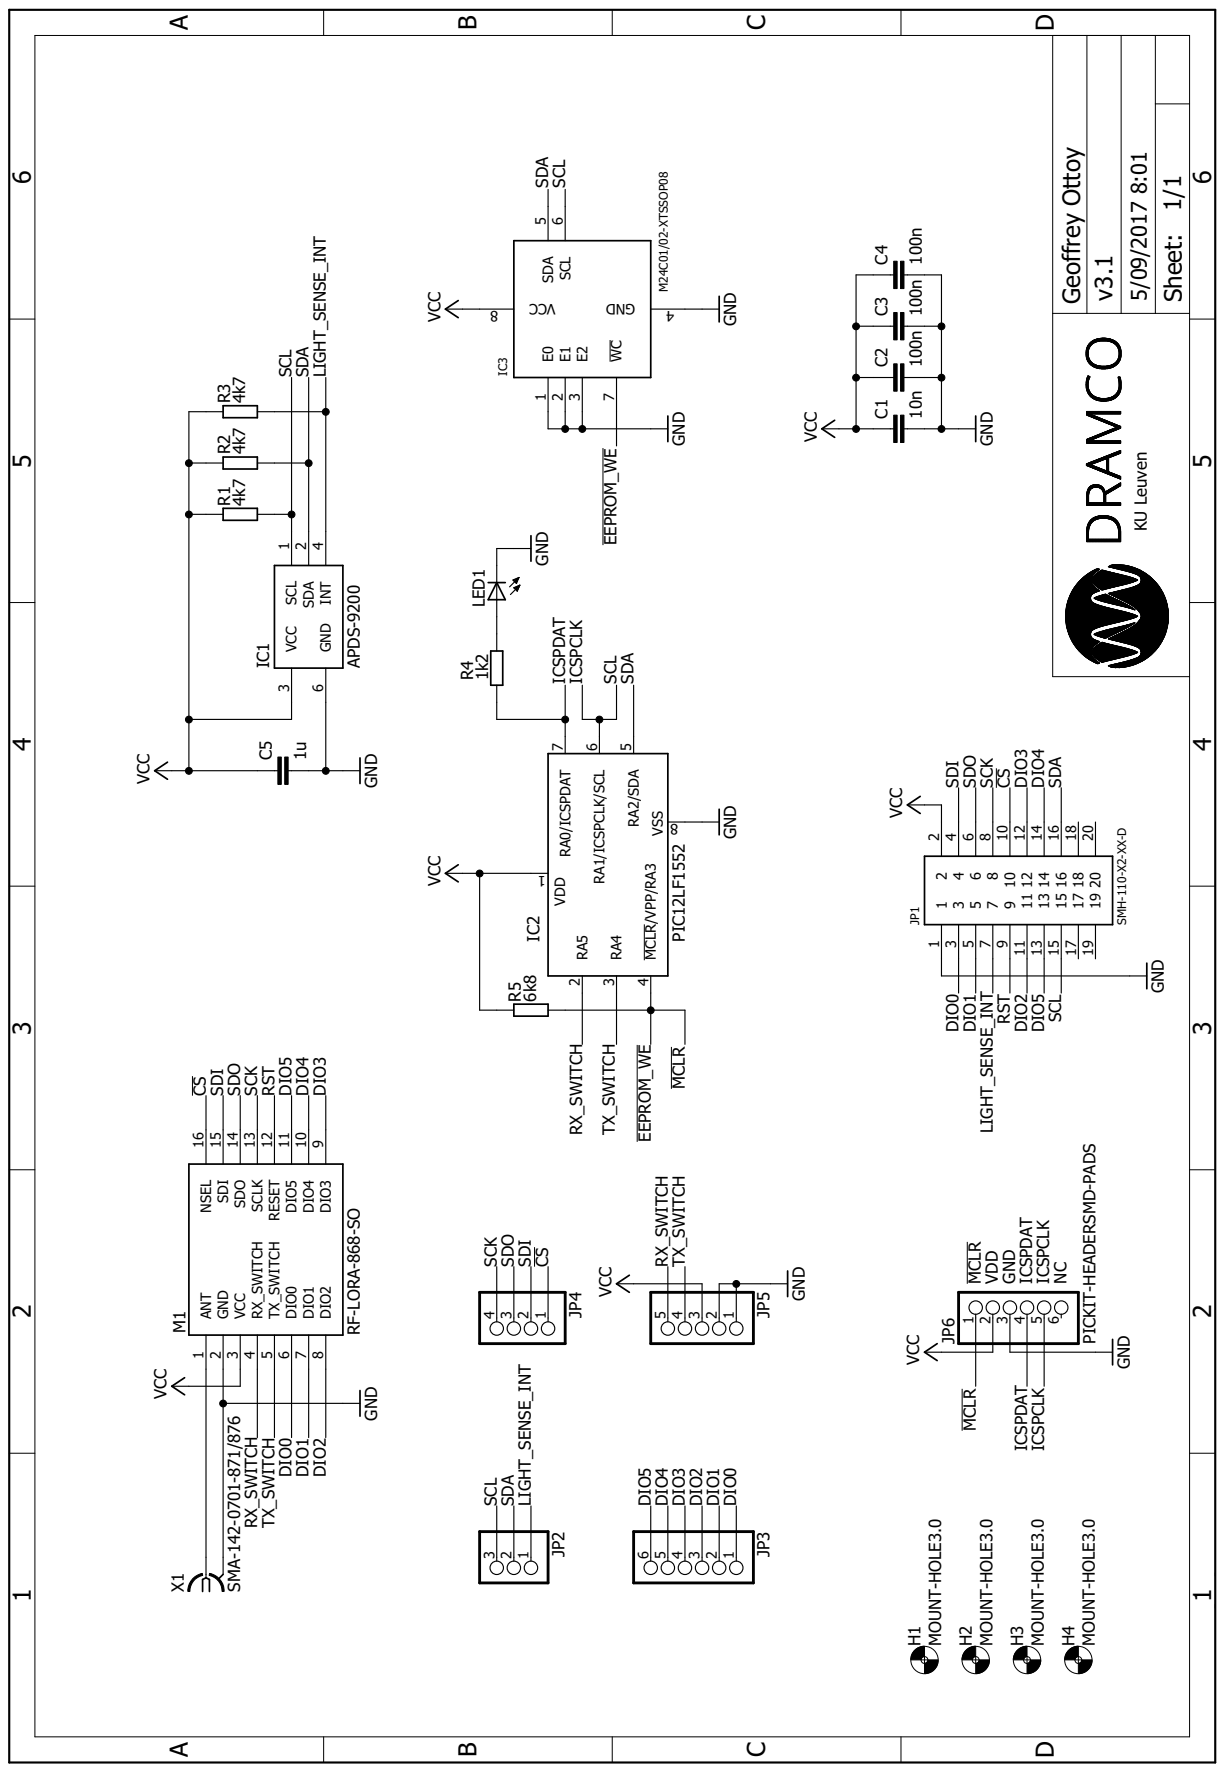
[picture p8: page 1]

Geof rey Ottoy KU Leuven MCLR VDD GND ICSPDAT ICSPCLK NC SMH-110-X2-XX-D GND VCC RF-LORA-868-SO VCC SMA-142-0701-871/876GND 10n 100n VCC GND 4k7 4k7 4k7 1u GND VCC VCC GND APDS-9200 MOUNT-HOLE3.0 MOUNT-HOLE3.0 MOUNT-HOLE3.0 MOUNT-HOLE3.0 PICKIT-HEADERSMD-PADS PIC12LF1552 GND 100n VCC GND VCC 100n M24C01/02-XTSSOP08 VCC GND GND 1k2 GND 6k8 ICSPCLK ICSPCLK EEPROM_WE EEPROM_WE JP11 1 2 2 3 3 4 4 5 5 6 6 7 7 8 8 9 9 10 10 11 11 12 12 13 13 14 14 15 15 16 16 17 17 18 18 19 19 20 20 ANT 1 GND 2 VCC 3 RX_SWITCH 4 TX_SWITCH 5 DIO0 6 DIO1 7 DIO2 8 DIO3 9 DIO4 10 DIO5 11 RESET 12 SCLK 13 SDO 14 SDI 15 NSEL 16 M1 X1 C1 C2 R1 R2 R3 C5 JP2 321JP3 654321 JP4 4321JP5 54321 VCC 3 GND 6 SCL 1 SDA 2 INT 4 IC1 H1H2H4H3 JP6123456 VDD VSS IC2 1 8 RA5 2 RA0/ICSPDAT 7 RA4 3 RA2/SDA 5 RA1/ICSPCLK/SCL 6 MCLR/VPP/RA3 4 C3 C4 E0 1 E1 2 E2 3 DNG 4 SDA 5 SCL 6 WC 7 CCV 8IC3 LED1 R4 R5 RX_SWITCH RX_SWITCH RX_SWITCH TX_SWITCH TX_SWITCH TX_SWITCH DIO0 DIO0 DIOD0IO1 DIO1 DIO1 DIO2 DIO2 DIO2 SCK SCK SCK SDO SDO SDO SDI SDI SDI CS CS CS RST RST DIO5 DIO5 DIO5 DIO4 DIO4 DIO4 DIO3 DIO3 DIO3 SCL SCL SCL SCL SCL SDA SDA SDA SDA SDA LIGHT_SENSE_INT LIGHT_SENSE_INT LIGHT_SENSE_INT ICSPDAT ICSPDAT MCLR MCLR v3.1 5/09/2017 8:01 1/1 Sheet: ABCD 1 2 3 4 5 6 ABCD 1 2 3 4 5 6
