guusleenders/Multi-RAT-for-IoT--The-Potential-in-Combining-LoRaWAN-and-NB-IoT/Hardware/NB-IoT/Version 3.brd

## EAGLE design Hardware/NB-IoT/Version 3.brd (2021-04-14)

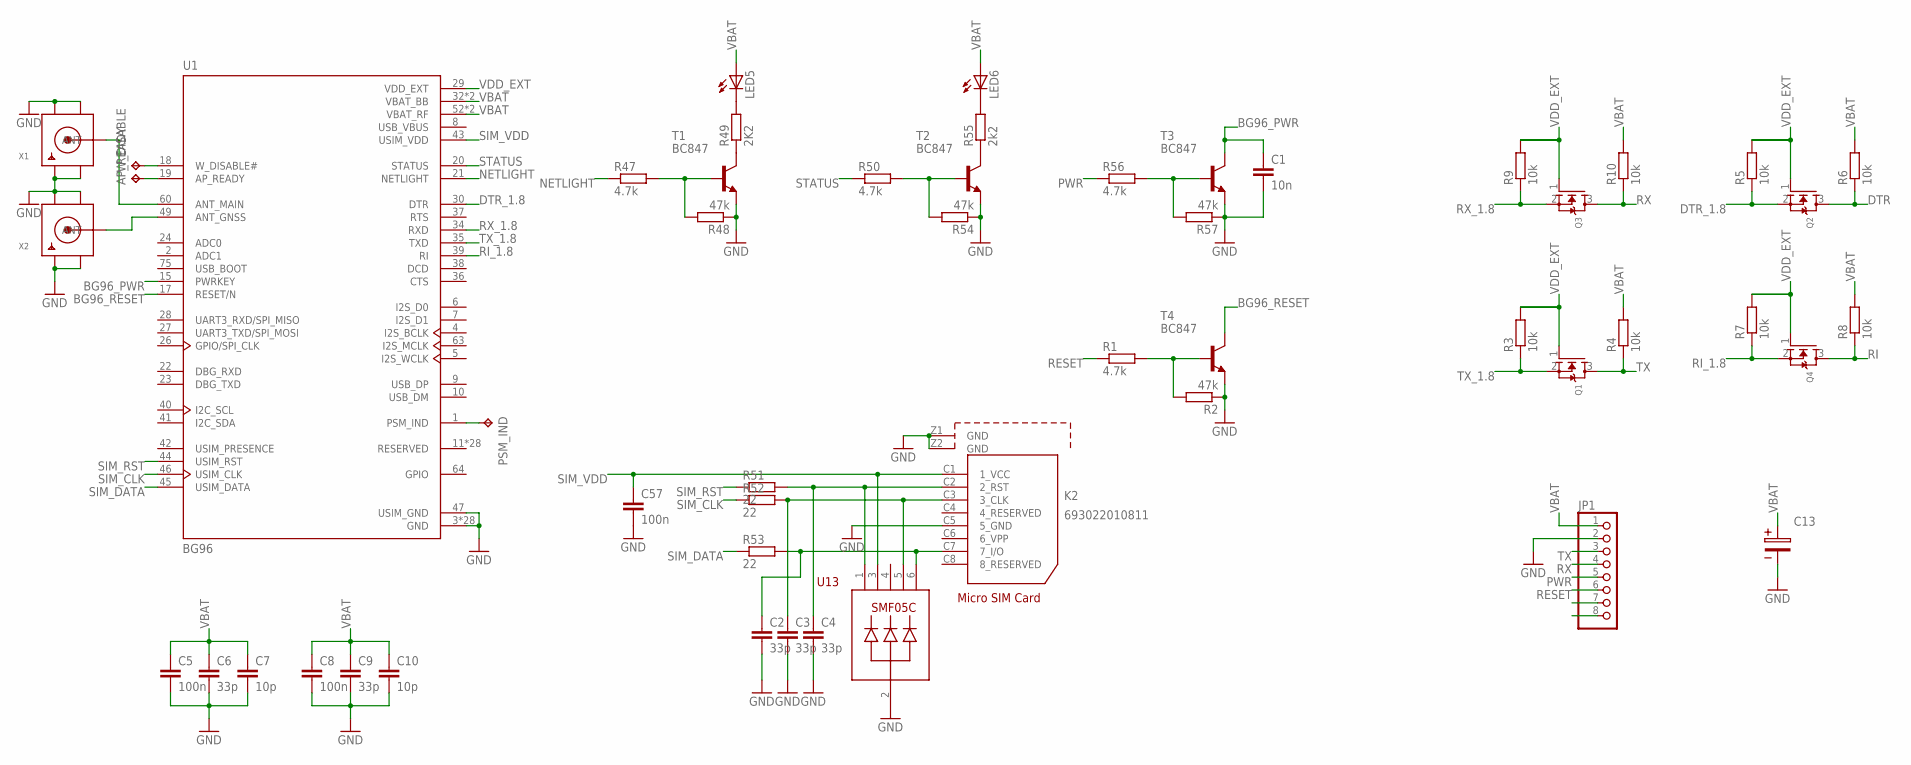
[picture p9: schematic Version 3.sch]

Parts:
AP_READY: TPTP10R; TP10R
C1: 10n; C0603
C2, C3, C4, C6, C9: 33p; C0603
C5, C8, C57: 100n; C0603
C7, C10: 10p; C0603
C13: WCAP-ASLI_6,3X7,7_865080545012; 3.5X1.6X2.1(BXCXA)
JP1: PINHD-1X8; 1X08
K2: 693022010811
LED5, LED6: LEDCHIPLED_0805; CHIPLED_0805
PSM_IND: TPTP10R; TP10R
Q1, Q2, Q3, Q4: MOSFET-NREFLOW; SOT23
R1, R47, R50, R56: 4.7k; R0603
R2, R48, R54, R57: 47k; R0603
R3, R4, R5, R6, R7, R8, R9, R10: 10k; R0603
R49: 2K2; R0603
R51, R52, R53: 22; R0603
R55: 2k2; R0603
T1, T2, T3, T4: BC847; SOT23
U1: BG96; LTE_MODULE_BG96
U13: SMF05C; SC-70-6
W_DISABLE: TPTP10R; TP10R
X1, X2: SMACONNECTOR_EDGE_UFL; SMA_EDGELAUNCH_UFL

Connections:
BG96_PWR: C1.1, T3.3 (C), U1.15 (PWRKEY)
BG96_RESET: T4.3 (C), U1.17 (RESET/N)
DTR: JP1.7, Q2.3 (D), R6.1
DTR_1.8: Q2.2 (S), R5.1, U1.30 (DTR)
GND: C1.2, C2.2, C3.2, C4.2, C5.2, C6.2, C7.2, C8.2, C9.2, C10.2, C13.2, C57.2, JP1.2, K2.C5 (5_GND), K2.Z1 (GND), K2.Z2 (GND), R2.1, R48.1, R54.1, R57.1, T1.2 (E), T2.2 (E), T3.2 (E), T4.2 (E), U1.3 (GND), U1.31 (GND), U1.47 (USIM_GND), U1.48 (GND), U1.50 (GND), U1.54 (GND), U1.55 (GND), U1.58 (GND), U1.59 (GND), U1.61 (GND), U1.62 (GND), U1.67 (GND), U1.68 (GND), U1.69 (GND), U1.70 (GND), U1.71 (GND), U1.72 (GND), U1.73 (GND), U1.74 (GND), U1.79 (GND), U1.80 (GND), U1.81 (GND), U1.82 (GND), U1.89 (GND), U1.90 (GND), U1.91 (GND), U1.100 (GND), U1.101 (GND), U1.102 (GND), U13.2, X1.GND@1 (GND1), X1.GND@2 (GND2), X1.GND@3 (GND3), X1.GND@4 (GND4), X2.GND@1 (GND1), X2.GND@2 (GND2), X2.GND@3 (GND3), X2.GND@4 (GND4)
unnamed: U1.60 (ANT_MAIN), X1.P (ANT)
unnamed: U1.49 (ANT_GNSS), X2.P (ANT)
unnamed: R1.2, R2.2, T4.1 (B)
unnamed: AP_READY.TP, U1.19 (AP_READY)
unnamed: U1.18 (W_DISABLE#), W_DISABLE.TP
unnamed: R56.2, R57.2, T3.1 (B)
unnamed: C4.1, K2.C2 (2_RST), R51.2, U13.1
unnamed: C3.1, K2.C3 (3_CLK), R52.2, U13.5
unnamed: C2.1, K2.C7 (7_I/O), R53.2, U13.6
unnamed: R47.2, R48.2, T1.1 (B)
unnamed: R49.1, T1.3 (C)
unnamed: LED5.C, R49.2
unnamed: R50.2, R54.2, T2.1 (B)
unnamed: R55.1, T2.3 (C)
unnamed: LED6.C, R55.2
NETLIGHT: R47.1, U1.21 (NETLIGHT)
PSM_IND: PSM_IND.TP, U1.1 (PSM_IND)
PWR: JP1.5, R56.1
RESET: JP1.6, R1.1
RI: JP1.8, Q4.3 (D), R8.1
RI_1.8: Q4.2 (S), R7.1, U1.39 (RI)
RX: JP1.4, Q3.3 (D), R10.1
RX_1.8: Q3.2 (S), R9.1, U1.34 (RXD)
SIM_CLK: R52.1, U1.46 (USIM_CLK)
SIM_DATA: R53.1, U1.45 (USIM_DATA)
SIM_RST: R51.1, U1.44 (USIM_RST)
SIM_VDD: C57.1, K2.C1 (1_VCC), U1.43 (USIM_VDD), U13.3
STATUS: R50.1, U1.20 (STATUS)
TX: JP1.3, Q1.3 (D), R4.1
TX_1.8: Q1.2 (S), R3.1, U1.35 (TXD)
USB_VBUS: U1.8 (USB_VBUS)
VBAT: C5.1, C6.1, C7.1, C8.1, C9.1, C10.1, C13.1, JP1.1, LED5.A, LED6.A, R4.2, R6.2, R8.2, R10.2, U1.32 (VBAT_BB), U1.33 (VBAT_BB), U1.52 (VBAT_RF), U1.53 (VBAT_RF)
VDD_EXT: Q1.1 (G), Q2.1 (G), Q3.1 (G), Q4.1 (G), R3.2, R5.2, R7.2, R9.2, U1.29 (VDD_EXT)

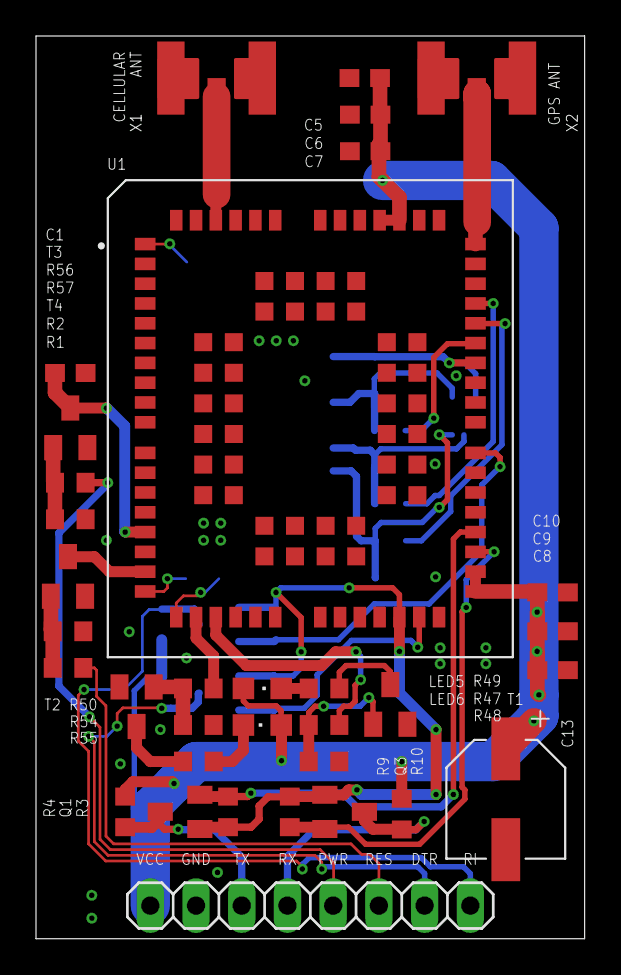
[picture p10: board Version 3.brd from above]

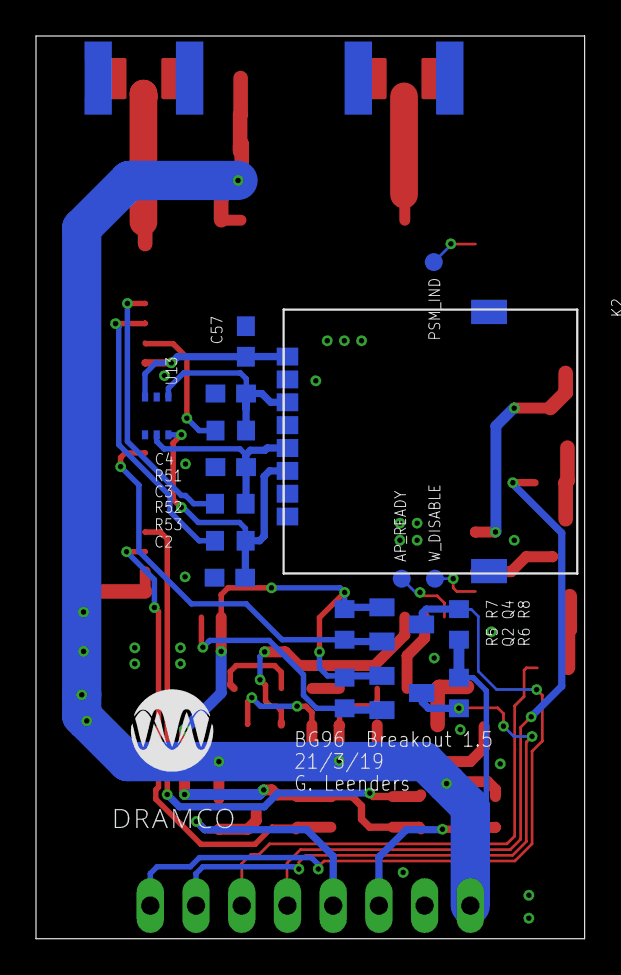
[picture p11: board Version 3.brd from below]

Board: 2 copper layers, 30.5 x 50.2 mm, 52 parts (18 on the bottom side), 37 nets.
