guusleenders/Multi-RAT-for-IoT--The-Potential-in-Combining-LoRaWAN-and-NB-IoT/Firmware/LoRaWAN/LoRaWAN_EFM32/DOC/Eagle/v3.2.brd

## EAGLE design Firmware/LoRaWAN/LoRaWAN_EFM32/DOC/Eagle/v3.2.brd (2021-04-14, an earlier design)

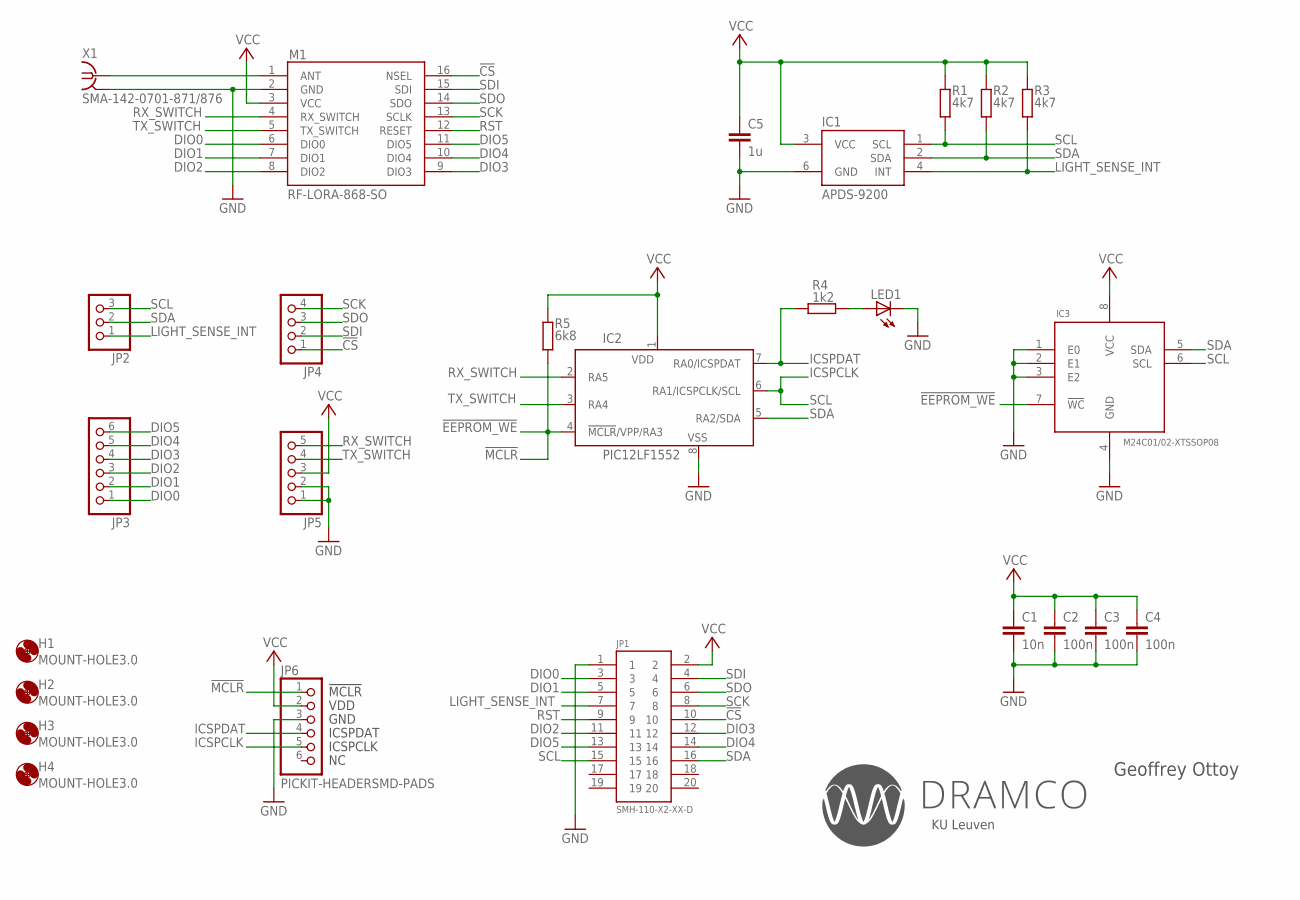
[picture p12: schematic v3.2.sch]

Parts:
C1: 10n; C0805K
C2, C3, C4: 100n; C0805K
C5: 1u; C0805K
H1, H2, H3, H4: MOUNT-HOLE3.0; 3,0
IC1: APDS-9200
IC2: PIC12LF1552; MSOP8
IC3: M24C01/02-XTSSOP08; TSSOP08
JP1: SMH-110-X2-XX-D
JP2: PINHD-1X3; 1X03
JP3: PINHD-1X6; 1X06
JP4: PINHD-1X4; 1X04
JP5: PINHD-1X5; 1X05
JP6: PICKIT-HEADERSMD-PADS; 1X06/SMD
LED1: LEDCHIP-LED0805; CHIP-LED0805
M1: RF-LORA-868-SO
R1, R2, R3: 4k7; M0805
R4: 1k2; M0805
R5: 6k8; M0805
X1: SMA-142-0701-871/876; J502-ND-142-0701-871/876

Connections:
!CS: JP1.10, JP4.1, M1.16 (NSEL)
!MCLR: IC2.4 (!MCLR!/VPP/RA3), IC3.7 (!WC), JP6.1, R5.1
ANT: M1.1 (ANT), X1.1
DIO0: JP1.3, JP3.1, M1.6 (DIO0)
DIO1: JP1.5, JP3.2, M1.7 (DIO1)
DIO2: JP1.11, JP3.3, M1.8 (DIO2)
DIO3: JP1.12, JP3.4, M1.9 (DIO3)
DIO4: JP1.14, JP3.5, M1.10 (DIO4)
DIO5: JP1.13, JP3.6, M1.11 (DIO5)
GND: C1.2, C2.2, C3.2, C4.2, C5.2, IC1.6 (GND), IC2.8 (VSS), IC3.1 (E0), IC3.2 (E1), IC3.3 (E2), IC3.4 (GND), JP1.1, JP5.1, JP5.2, JP6.3, LED1.C, M1.2 (GND), X1.G@1 (2), X1.G@2 (2), X1.G@3 (2), X1.G@4 (2)
ICSPDAT: IC2.7 (RA0/ICSPDAT), JP6.4, R4.2
LIGHT_SENSE_INT: IC1.4 (INT), JP1.7, JP2.1, R3.1
unnamed: LED1.A, R4.1
RST: JP1.9, M1.12 (RESET)
RX_SWITCH: IC2.2 (RA5), JP5.5, M1.4 (RX_SWITCH)
SCK: JP1.8, JP4.4, M1.13 (SCLK)
SCL: IC1.1 (SCL), IC2.6 (RA1/ICSPCLK/SCL), IC3.6 (SCL), JP1.15, JP2.3, JP6.5, R1.1
SDA: IC1.2 (SDA), IC2.5 (RA2/SDA), IC3.5 (SDA), JP1.16, JP2.2, R2.1
SDI: JP1.4, JP4.2, M1.15 (SDI)
SDO: JP1.6, JP4.3, M1.14 (SDO)
TX_SWITCH: IC2.3 (RA4), JP5.4, M1.5 (TX_SWITCH)
VCC: C1.1, C2.1, C3.1, C4.1, C5.1, IC1.3 (VCC), IC2.1 (VDD), IC3.8 (VCC), JP1.2, JP5.3, JP6.2, M1.3 (VCC), R1.2, R2.2, R3.2, R5.2

Notes on the sheet:
Geoffrey Ottoy
KU Leuven
ICSPCLK
!EEPROM_WE

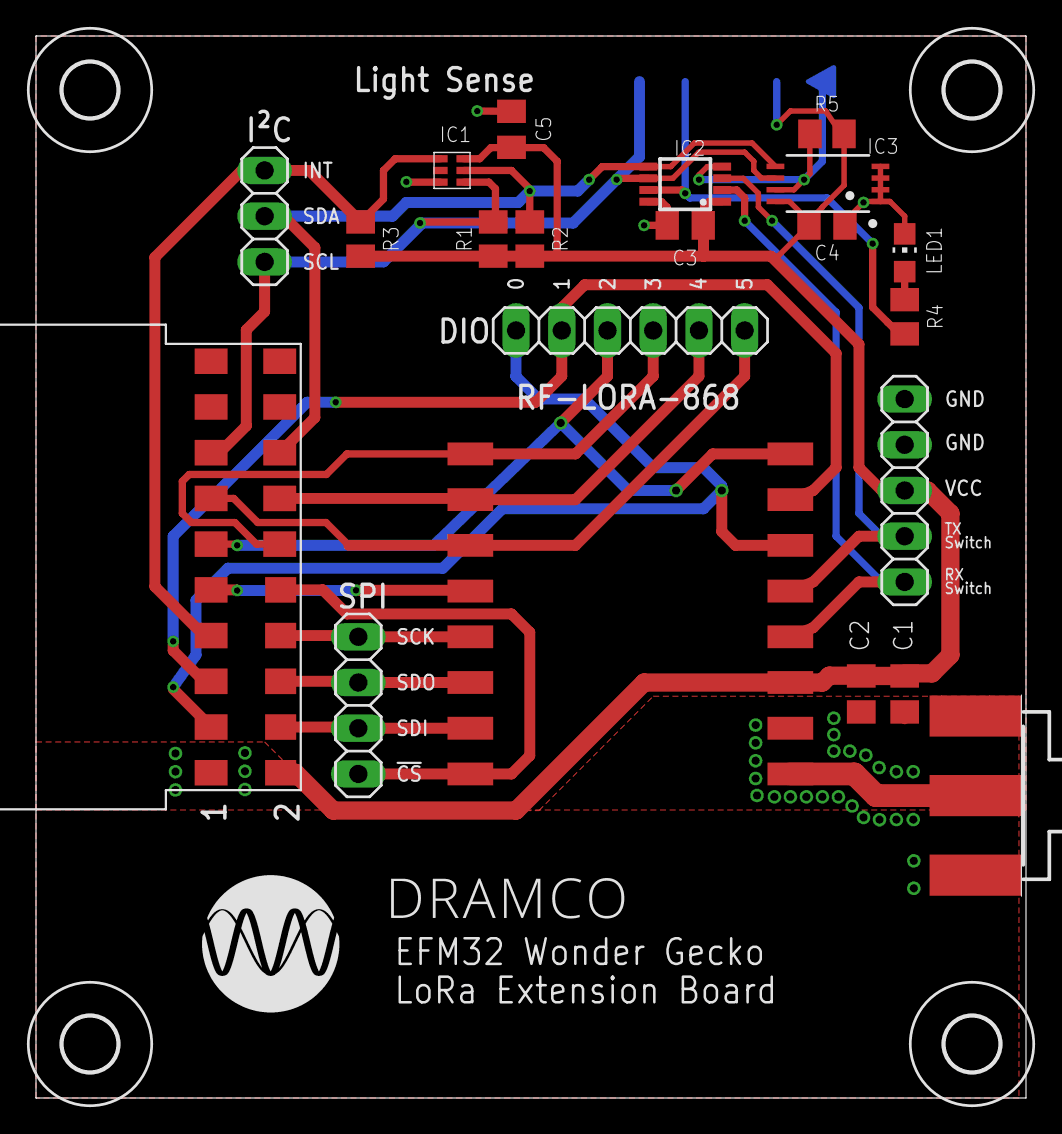
[picture p13: board v3.2.brd from above]

Board: 2 copper layers, 55.0 x 59.0 mm, 26 parts (1 on the bottom side), 22 nets.
