guusleenders/Multi-RAT-for-IoT--The-Potential-in-Combining-LoRaWAN-and-NB-IoT/Firmware/LoRaWAN/LoRaWAN_EFM32/DOC/Eagle/v4.0.brd

## EAGLE design Firmware/LoRaWAN/LoRaWAN_EFM32/DOC/Eagle/v4.0.brd (2021-04-14)

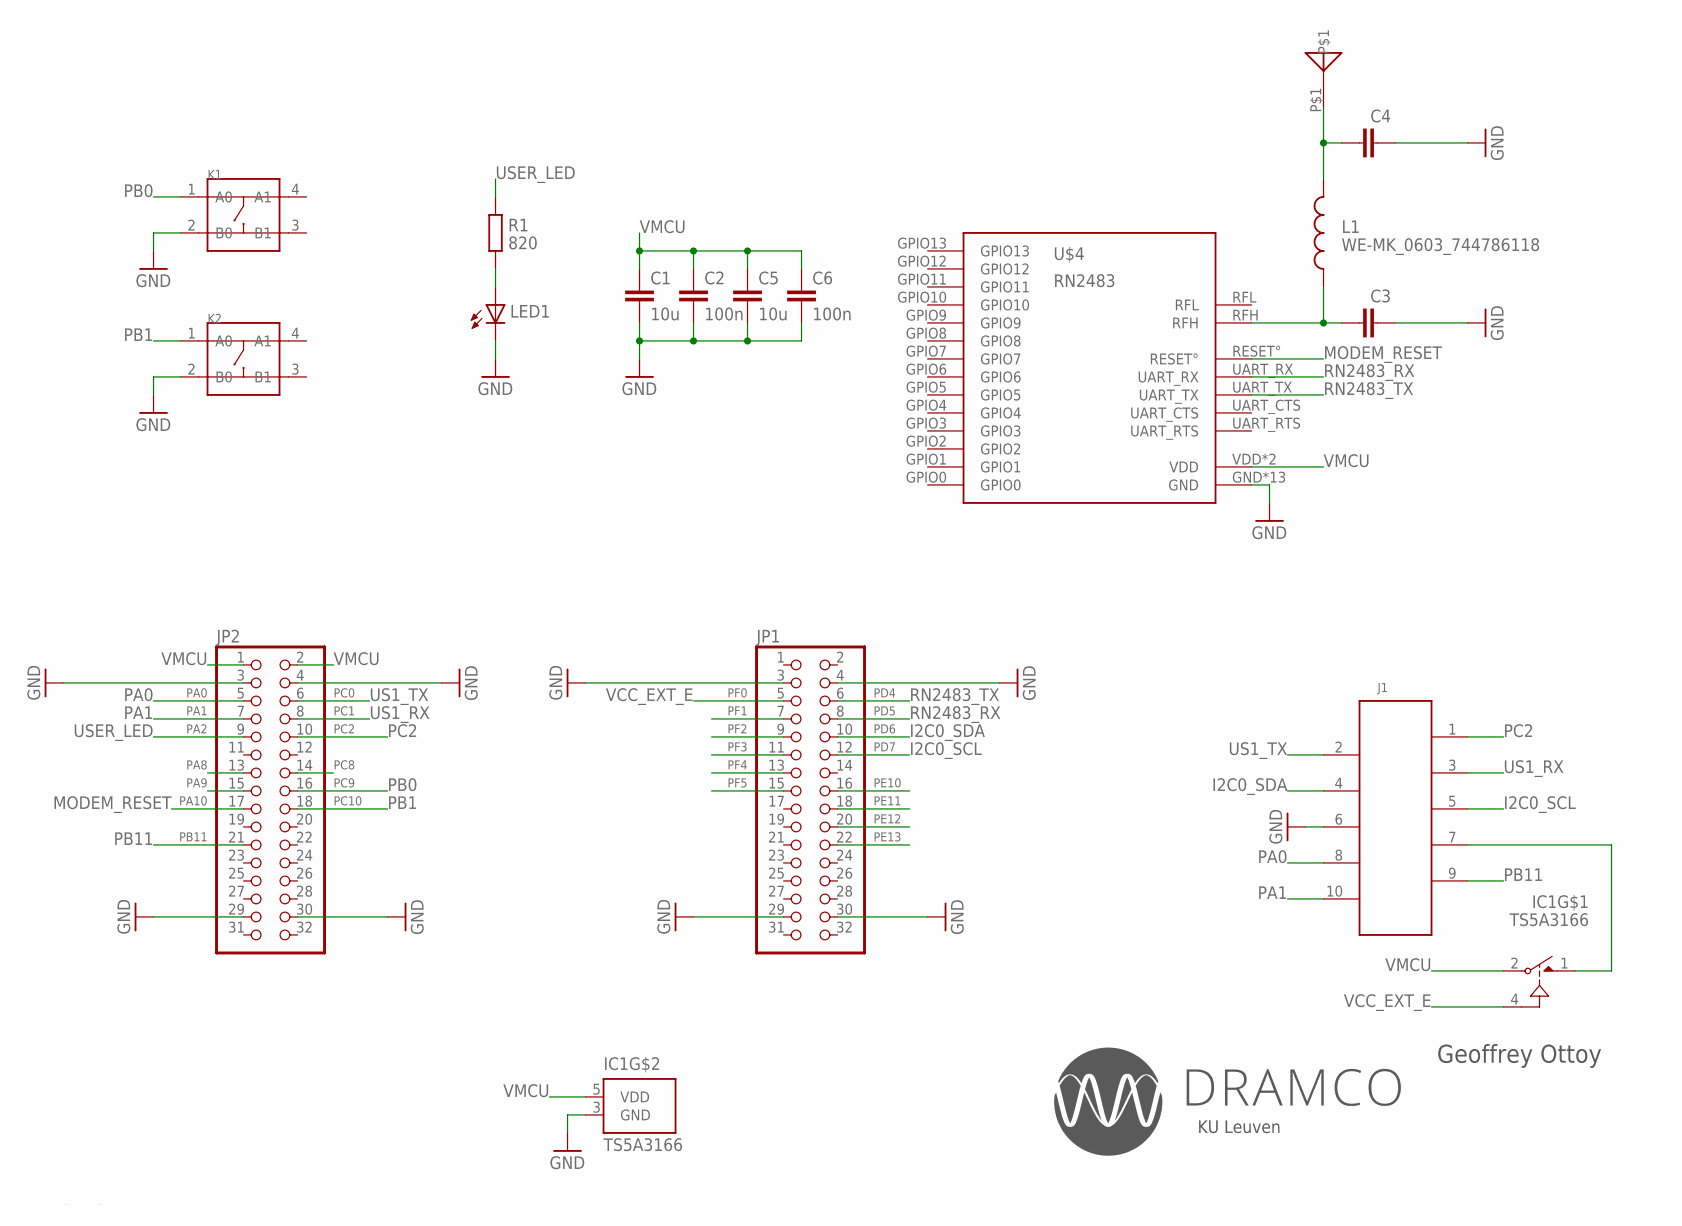
[picture p14: schematic v4.0.sch]

Parts:
C1, C5: 10u; C0805K
C2, C6: 100n; C0805K
C3, C4: C-EUC0603K; C0603K
IC1: TS5A3166; SC70-5L
J1: 61001018321
JP1, JP2: PINHD-2X16; 2X16
K1, K2: SMD-SWITCH-TACTILE-SPST-NO(4P-D6.0MM); SW4-SMD-6.0X6.0X5.0MM
L1: WE-MK_0603_744786118; WE-MK_0603
LED1: LEDCHIPLED_0805; CHIPLED_0805
R1: 820; R0805
U$2: ANTENNA868; CERAMIC-ANTENNA
U$4: RN2483

Connections:
GND: C1.2, C2.2, C3.1, C4.1, C5.2, C6.2, IC1.3 (GND), J1.6 (5), JP1.3, JP1.4, JP1.29, JP1.30, JP2.3, JP2.4, JP2.29, JP2.30, K1.2 (B0), K2.2 (B0), LED1.C, U$4.GND, U$4.GND1 (GND), U$4.GND2 (GND), U$4.GND3 (GND), U$4.GND4 (GND), U$4.GND5 (GND), U$4.GND6 (GND), U$4.GND7 (GND), U$4.GND8 (GND), U$4.GND9 (GND), U$4.GND10 (GND), U$4.GND11 (GND), U$4.GND12 (GND)
unnamed: LED1.A, R1.1
unnamed: C3.2, L1.1, U$4.RFH
unnamed: C4.2, L1.2, U$2.P$1
unnamed: IC1.1 (NO), J1.7 (4)
PA0: J1.8 (3), JP2.5
PA1: J1.10 (1), JP2.7
PA2: JP2.9, R1.2
PA8: JP2.13
PA9: JP2.15
PA10: JP2.17, U$4.RESET°
PB11: J1.9 (2), JP2.21
PC0: J1.2 (9), JP2.6
PC1: J1.3 (8), JP2.8
PC2: J1.1 (10), JP2.10
PC8: JP2.14
PC9: JP2.16, K1.1 (A0)
PC10: JP2.18, K2.1 (A0)
PD4: JP1.6, U$4.UART_TX
PD5: JP1.8, U$4.UART_RX
PD6: J1.4 (7), JP1.10
PD7: J1.5 (6), JP1.12
PE10: JP1.16
PE11: JP1.18
PE12: JP1.20
PE13: JP1.22
PF0: IC1.4 (IN), JP1.5
PF1: JP1.7
PF2: JP1.9
PF3: JP1.11
PF4: JP1.13
PF5: JP1.15
VMCU: C1.1, C2.1, C5.1, C6.1, IC1.2 (COM), IC1.5 (VDD), JP2.1, JP2.2, U$4.VDD, U$4.VDD2 (VDD)

Notes on the sheet:
Geoffrey Ottoy
KU Leuven
I2C0_SDA
I2C0_SCL
PC2
PB0
PB1
PA0
PA1
PB11
MODEM_RESET
RN2483_RX
RN2483_TX
US1_TX
US1_RX
USER_LED
VCC_EXT_E

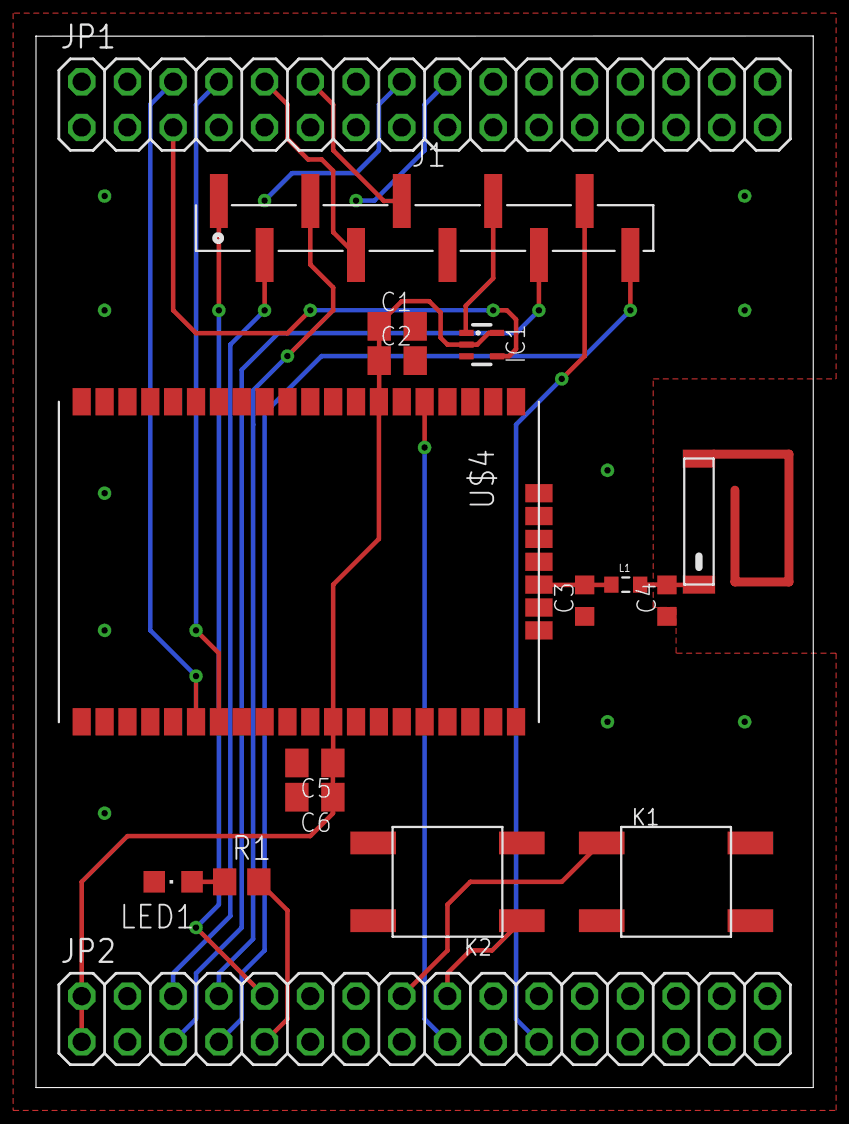
[picture p15: board v4.0.brd from above]

Board: 2 copper layers, 43.2 x 58.4 mm, 17 parts (0 on the bottom side), 21 nets.
