guusleenders/Multi-RAT-for-IoT--The-Potential-in-Combining-LoRaWAN-and-NB-IoT/Firmware/LoRaWAN/LoRaWAN_EFM32/src/main.c

/*  ____  ____      _    __  __  ____ ___
 * |  _ \|  _ \    / \  |  \/  |/ ___/ _ \
 * | | | | |_) |  / _ \ | |\/| | |  | | | |
 * | |_| |  _ <  / ___ \| |  | | |__| |_| |
 * |____/|_| \_\/_/   \_\_|  |_|\____\___/
 *                           research group
 *                             dramco.be/
 *
 *   KU Leuven - Technology Campus Gent,
 *   Gebroeders De Smetstraat 1,
 *   B-9000 Gent, Belgium
 *
 *         File: main.c
 *      Created: 2017-09-20
 *       Author: Geoffrey Ottoy
 *
 *  Description: Main function running on the EFM32.
 *  	The type of application can be selected (see app_select.h)
 */


#include "app_select.h"
#if defined(APP_TYPE) && (APP_TYPE == EXAMPLE_APP)
#include "example_app.h"
#endif
#if defined(APP_TYPE) && (APP_TYPE == AES_APP)
#include "aes_app.h"
#endif
#if defined(APP_TYPE) && (APP_TYPE == DEEP_SLEEP_APP)
#include "deep_sleep_app.h"
#endif

int main(void){
#if defined(APP_TYPE) && (APP_TYPE == AES_APP)
	main_aes();
#endif

#if defined(APP_TYPE) && (APP_TYPE == EXAMPLE_APP)
	main_example();
#endif

#if defined(APP_TYPE) && (APP_TYPE == DEEP_SLEEP_APP)
	main_deep_sleep();
#endif
	while(1);
}
