guusleenders/Multi-RAT-for-IoT--The-Potential-in-Combining-LoRaWAN-and-NB-IoT/Firmware/LoRaWAN/LoRaWAN_EFM32/boards/gpio-board.h

/*
 / _____)             _              | |
( (____  _____ ____ _| |_ _____  ____| |__
 \____ \| ___ |    (_   _) ___ |/ ___)  _ \
 _____) ) ____| | | || |_| ____( (___| | | |
(______/|_____)_|_|_| \__)_____)\____)_| |_|
    (C)2013 Semtech

Description: Bleeper board GPIO driver implementation

License: Revised BSD License, see LICENSE.TXT file include in the project

Maintainer: Miguel Luis and Gregory Cristian
*/
#ifndef __GPIO_MCU_H__
#define __GPIO_MCU_H__

/*!
 * \brief Initializes the given GPIO object
 *
 * \param [IN] obj    Pointer to the GPIO object to be initialized
 * \param [IN] pin    Pin name ( please look in pinName-board.h file )
 * \param [IN] mode   Pin mode [PIN_INPUT, PIN_OUTPUT,
 *                              PIN_ALTERNATE_FCT, PIN_ANALOGIC]
 * \param [IN] config Pin config [PIN_PUSH_PULL, PIN_OPEN_DRAIN]
 * \param [IN] type   Pin type [PIN_NO_PULL, PIN_PULL_UP, PIN_PULL_DOWN]
 * \param [IN] value  Default output value at initialisation
 */
void GpioMcuInit( Gpio_t *obj, PinNames pin, PinModes mode, PinConfigs config, PinTypes type, uint32_t value );
  
/*!
 * \brief GPIO IRQ Initialization
 *
 * \param [IN] obj         Pointer to the GPIO object to be initialized
 * \param [IN] irqMode     IRQ mode [NO_IRQ, IRQ_RISING_EDGE,
 *                                  IRQ_FALLING_EDGE, IRQ_RISING_FALLING_EDGE]
 * \param [IN] irqPriority IRQ priority [IRQ_VERY_LOW_PRIORITY, IRQ_LOW_PRIORITY
 *                                       IRQ_MEDIUM_PRIORITY, IRQ_HIGH_PRIORITY
 *                                       IRQ_VERY_HIGH_PRIORITY]
 * \param [IN] irqHandler  Callback function pointer
 */
void GpioMcuSetInterrupt( Gpio_t *obj, IrqModes irqMode, IrqPriorities irqPriority, GpioIrqHandler *irqHandler );

/*!
 * \brief GPIO IRQ DeInitialization
 *
 * \param [IN] obj         Pointer to the GPIO object to be Deinitialized
 */
void GpioMcuRemoveInterrupt( Gpio_t *obj );

/*!
 * \brief Writes the given value to the GPIO output
 *
 * \param [IN] obj    Pointer to the GPIO object
 * \param [IN] value  New GPIO output value
 */
void GpioMcuWrite( Gpio_t *obj, uint32_t value );

/*!
 * \brief Toggle the value to the GPIO output
 *
 * \param [IN] obj    Pointer to the GPIO object
 */
void GpioMcuToggle( Gpio_t *obj );

/*!
 * \brief Reads the current GPIO input value
 *
 * \param [IN] obj    Pointer to the GPIO object
 * \retval value  Current GPIO input value
 */
uint32_t GpioMcuRead( Gpio_t *obj );

#endif // __GPIO_MCU_H__
