guusleenders/Multi-RAT-for-IoT--The-Potential-in-Combining-LoRaWAN-and-NB-IoT/(commit log)

2021-06-17 Changed file names
    [Version 3.GBL, Version 3.GBO, Version 3.GBP, Version 3.GBS, Version 3.GTL, Version 3.GTO, Version 3.GTP, Version 3.GTS]
2021-07-02 Added BOM comparison
    [Bom Comparison.xlsx]
2021-07-05 Added measurement files
    [Desk - 0dB Attenuation (2).csv, Desk - 0dB Attenuation (3).csv, Desk - 0dB Attenuation (4).csv, Desk - 0dB Attenuation (5).csv, Desk - 0dB Attenuation.csv, Desk - 100dB Attenuation.csv, Desk - 120dB Attenuation.csv, Desk - 20dB Attenuation (2).csv]
