guusleenders/Multi-RAT-for-IoT--The-Potential-in-Combining-LoRaWAN-and-NB-IoT/(notices)

Notices in the files:
parts and their libraries:
Kondensatoren: Copyright: Würth Elektronik
